gheimsch/Pulse_oximetry/Bericht/Titelbild.png

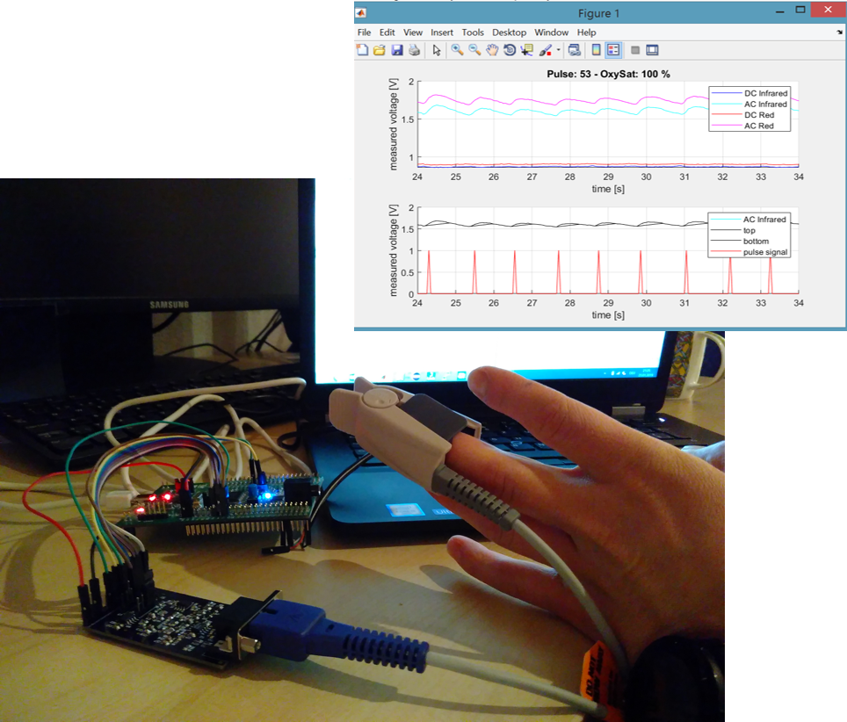
Bericht/Titelbild.png
