gheimsch/Pulse_oximetry/Bericht/IMG_20190123_212548.jpg

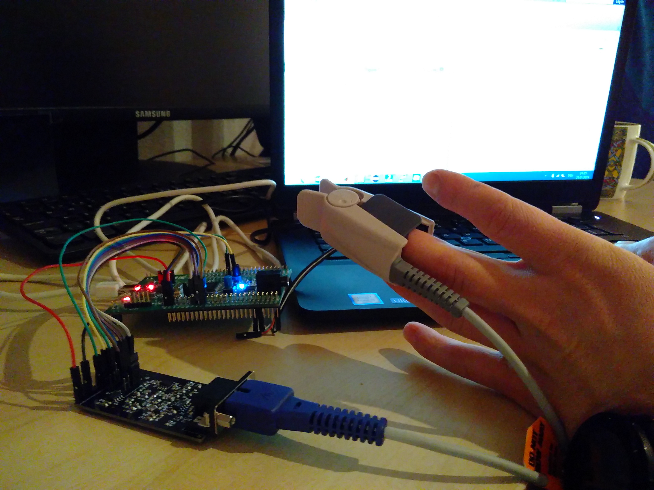
Bericht/IMG_20190123_212548.jpg
