gheimsch/Pulse_oximetry/README.md

# Pulse_oximetry
CAS Sensorik und Sensor Signal Conditioning Projektarbeit
