gheimsch/Pulse_oximetry/Bericht/Oxymeter.pptx

## Oximeter Messung von Puls und Sauerstoffsättigung

Gunnar Heimsch, Krista Kappeler
25.1.2019

## Agenda

- Ziele
- Messprinzip
- Medizinischer Hintergrund
- Dimensionierung und Simulation
- Schema
- Blockschaltbild
- Berechnung Puls und Sauerstoffsättigung
- Demo
- Vergleich zu anderen Produkten
- Fazit u. Schlusswort
- Fragen

## Ziel

- Elektronik bauen zum Aufnehmen und Aufbereiten (Signal Conditioning) von «Pulsoxymetrie» Rohdaten (Lichtsensor Infrarot und Rot)
- Visualisierung u. Auswertung der Rohdaten
- Vergleich mit anderen Produkten (z.B. eval board, fertiges Produkt, etc.)

## Messprinzip

- LED Rot – 665nm
- LED Infrarot – 940nm
- Fotodiode

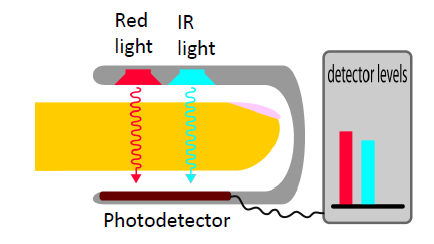
[picture p3: figure]

## Medizinischer Hintergrund

- Arterielles Blut pulsiert mit Herzfrequenz, enthält Hb02 u. Hb
- Sauerstoffsättigung: Verhältnis von HbO2 (Oxyhämoglobin) u. Hb (Hämoglobin)

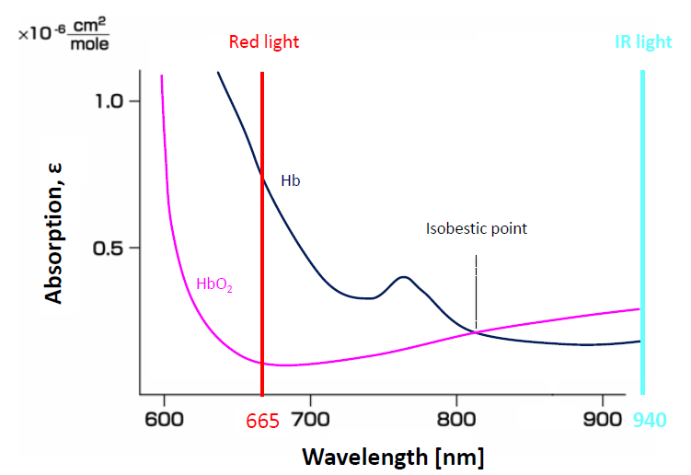
[picture p4: figure]
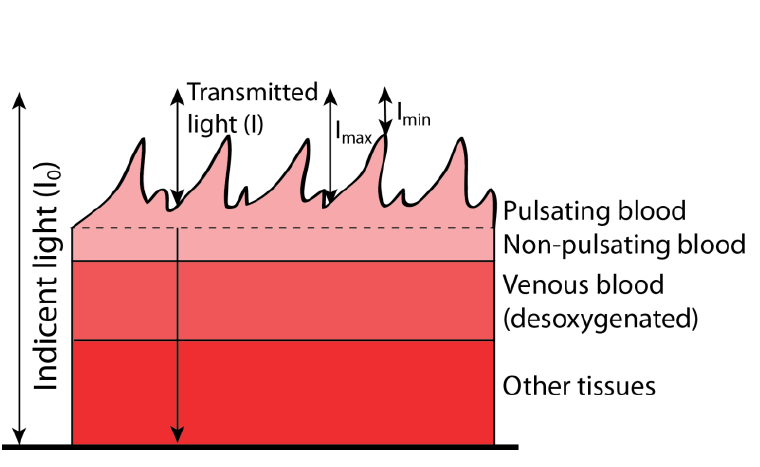
[picture p5: figure]

## Dimensionierung: Signal LED Infrarot

- Rohdaten mim Steckbrett
  - Basis für Auslegung
- Keine Infos über diesen IR Sensor

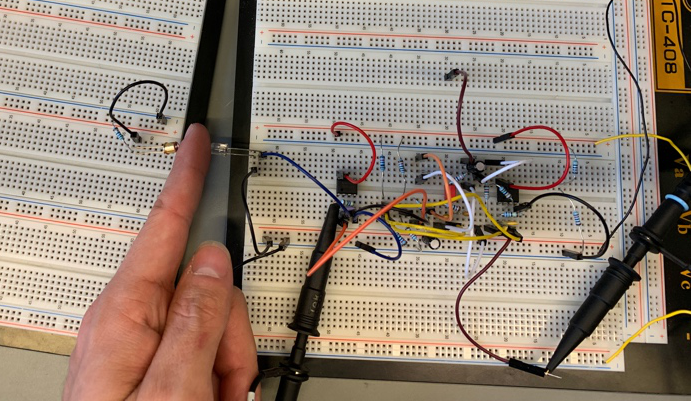
[picture p6: figure]
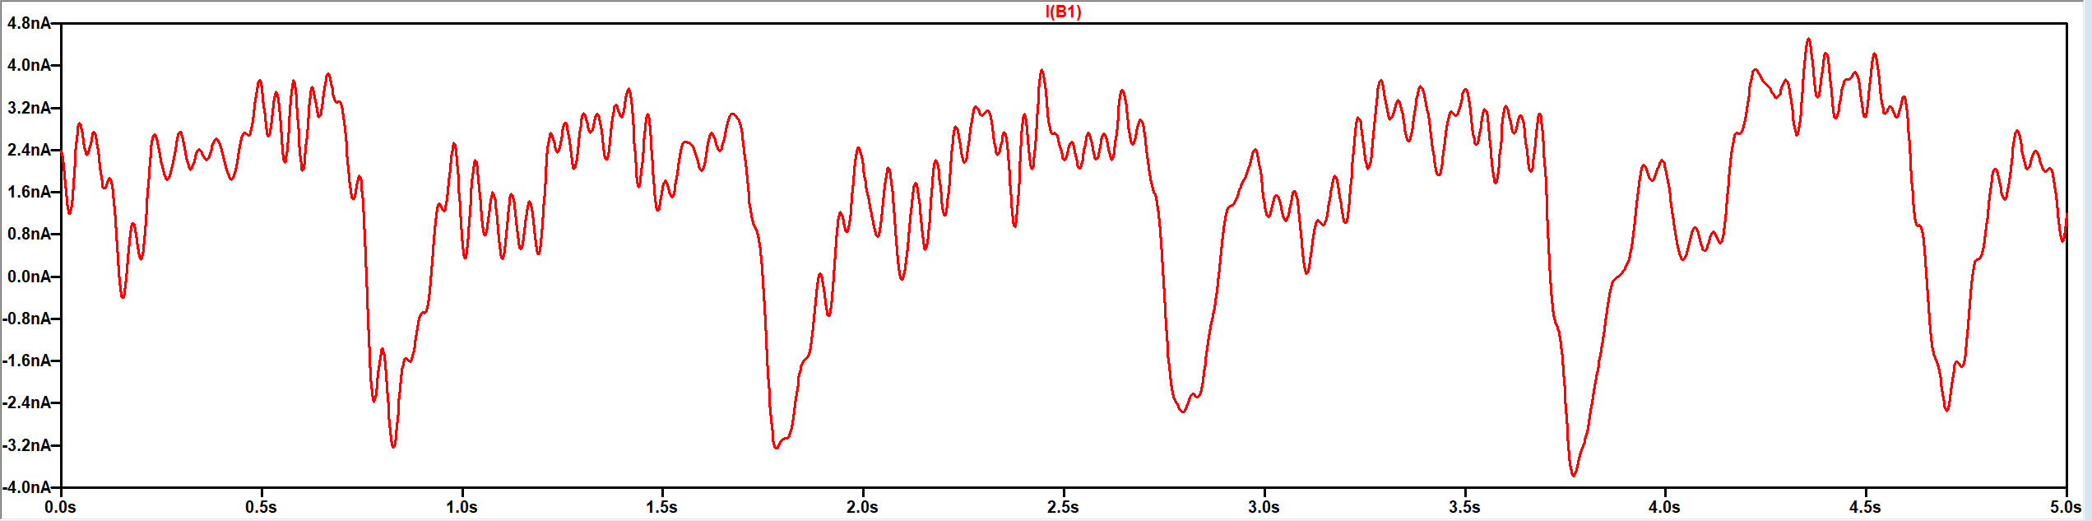
[picture p7: figure]

## Dimensionierung: Auslegung Filter

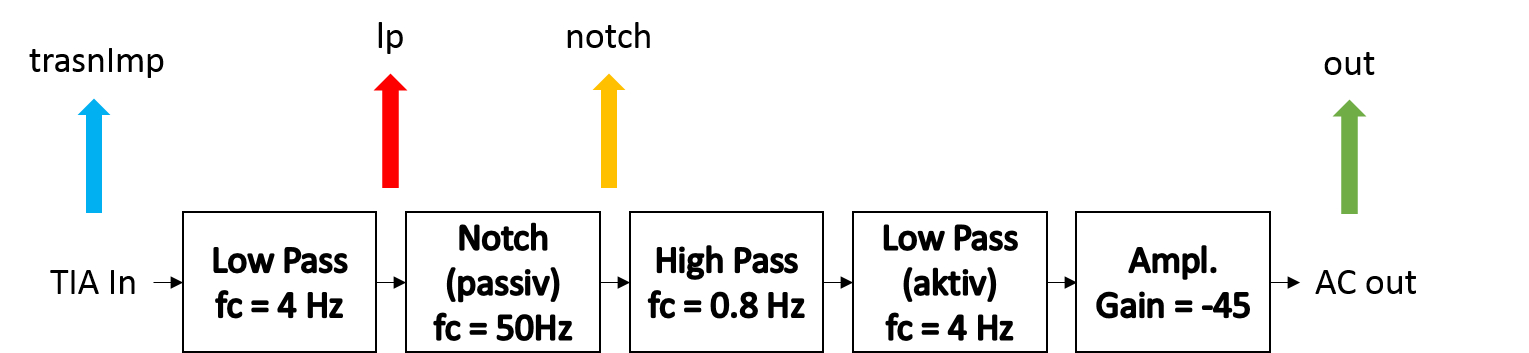
[picture p8: figure]
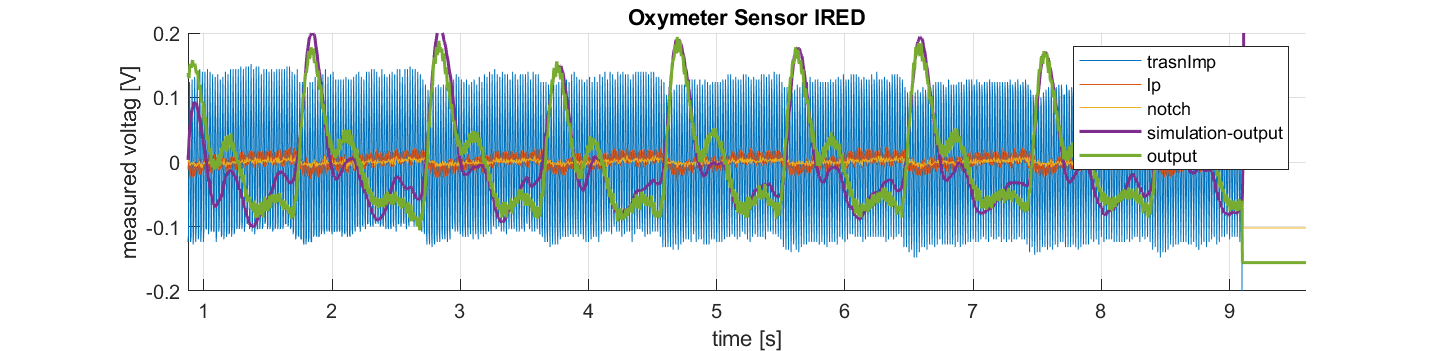
[picture p9: figure]

## Dimensionierung: Auslegung Notch Filter

- Aktiver Notch filter 50 Hz
  - Steiler ist nicht immer besser

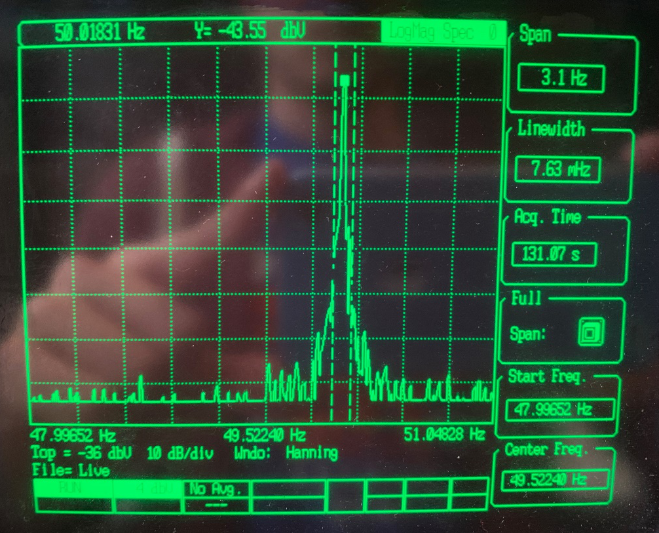
[picture p10: figure]
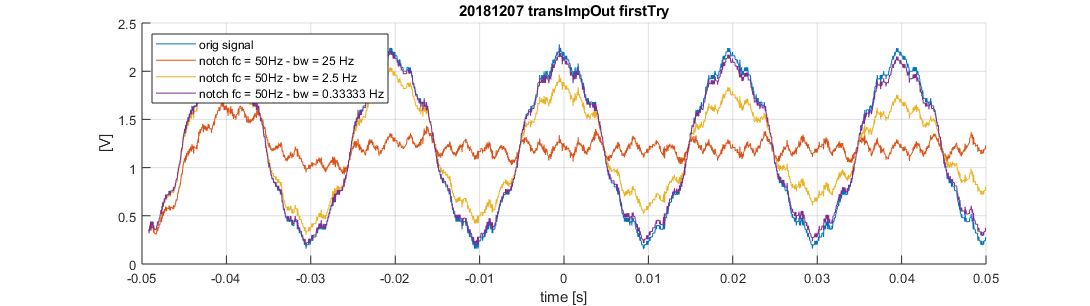
[picture p11: figure]

## Simulation: Gesamter Pfad

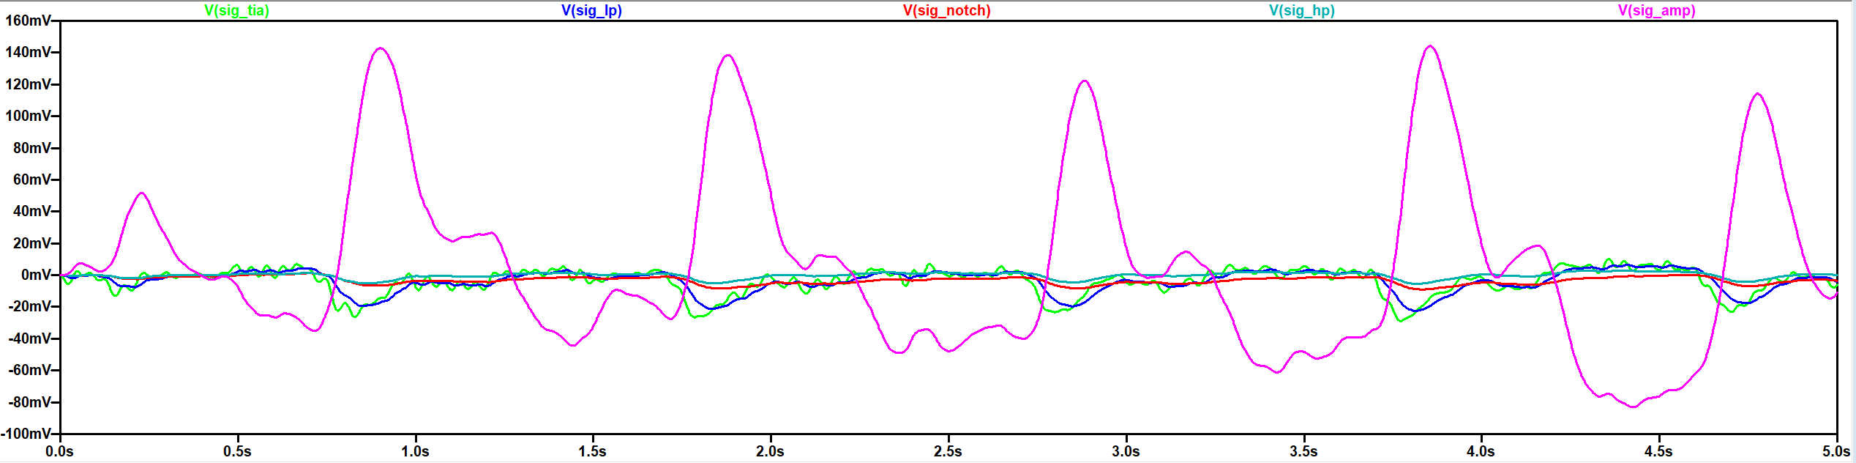
[picture p12: figure]
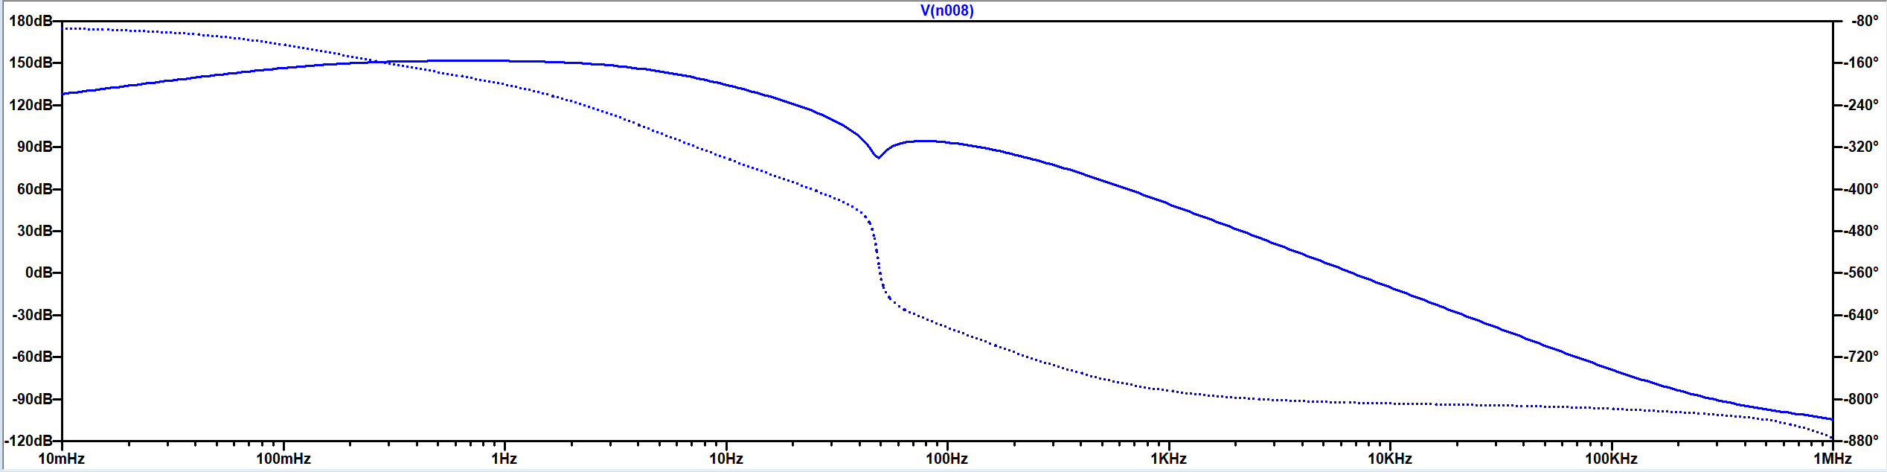
[picture p13: figure]

## Simulation: Stabilisierung TIA

- C_F = 1/(4∗π∗R_F ∗f_(GBWP))(1+√(1+8∗π∗C_i ∗f_(GBWP)))
- => ca. 0.5pF

## Simulation: Stabilisierung TIA

- Instabil ohne Feedback Kondensator

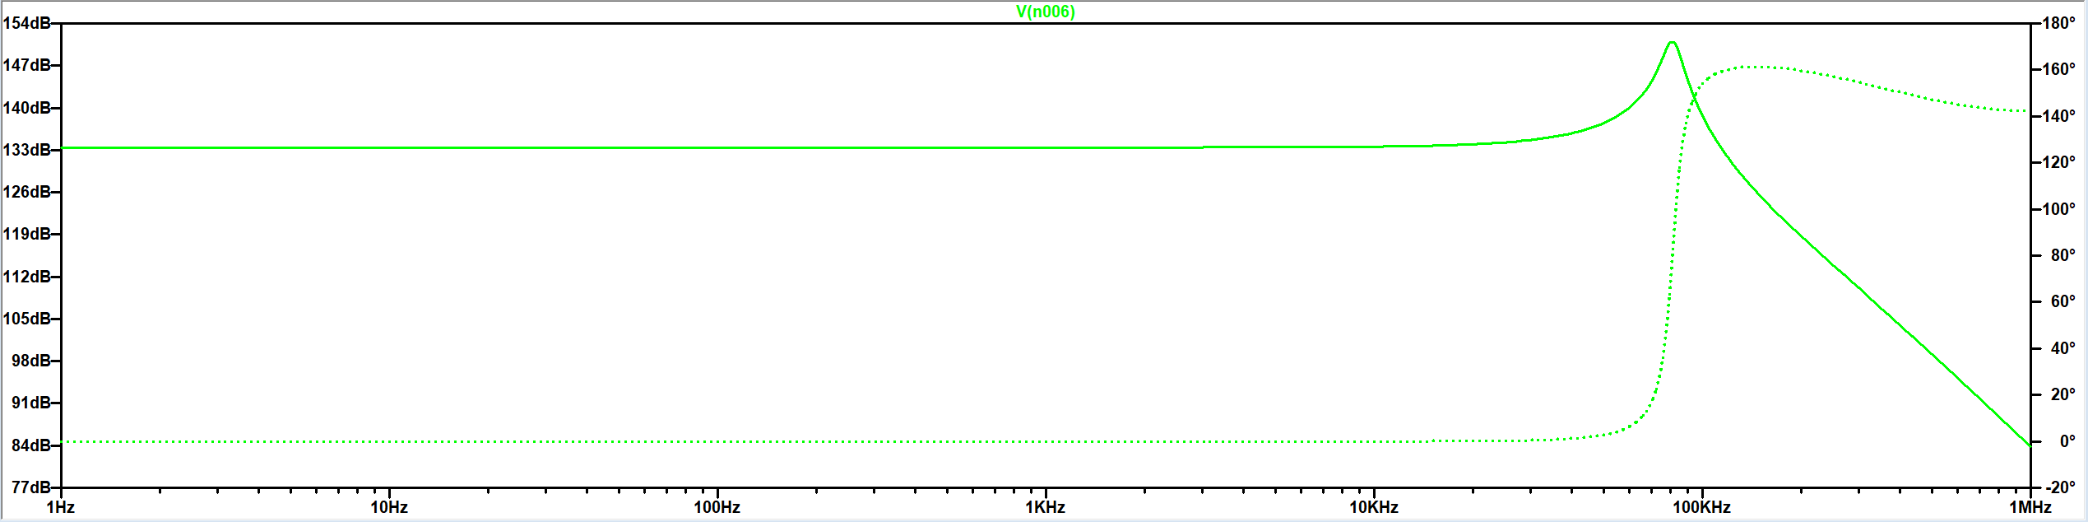
[picture p14: figure]

Stabil mit Feedback Kondensator 270pF

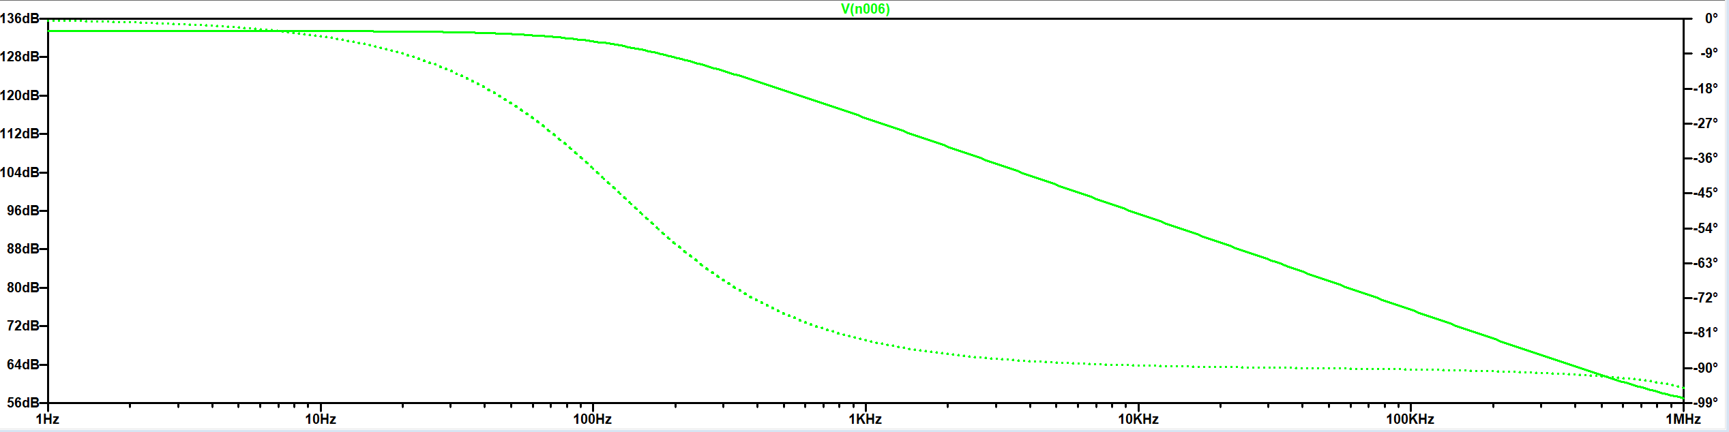
[picture p15: figure]

## Schema H-Brücke

- LED’s (Infrarot u. Rot) über eine H-Brücke angesteuert, da Sensor antiparallel geschaltet ist
- Mit DAC Strom der LED zwischen 0mA und 20mA einstellen
- R8 limitiert Strom → kein Kurzschluss

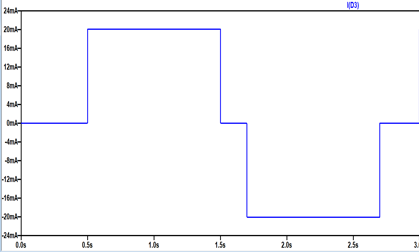
[picture p16: figure]
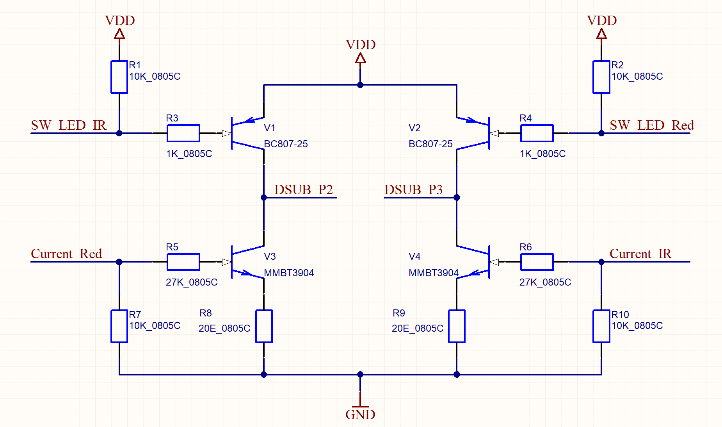
[picture p17: figure]

## Schema Filter, Verstärker

- TIA
- LP, Notch, HP, LP
- Verstärker G=-45

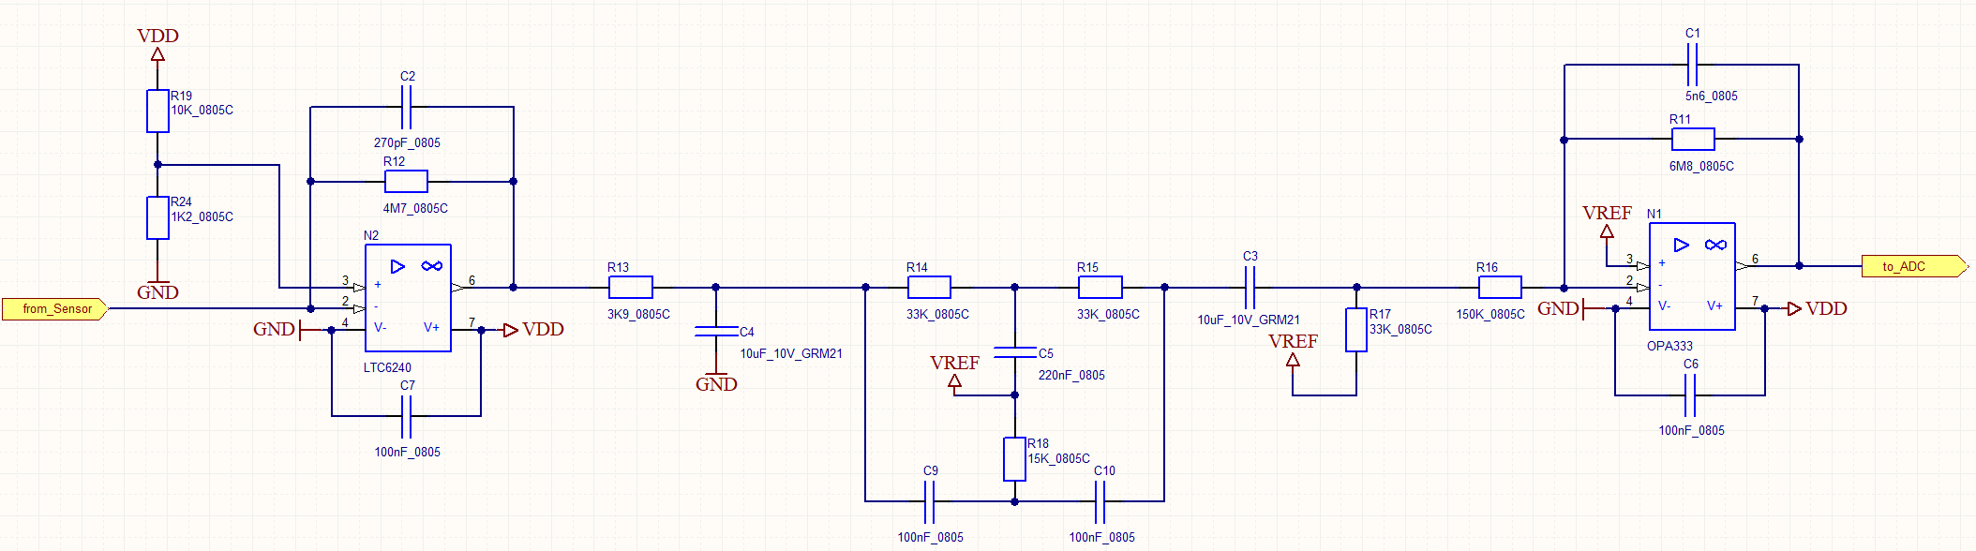
[picture p18: figure]

## Blockschaltbild

- STM32F4-Discovery für analoge Werte, Steuerung H-Brücke
- Rohdaten mittels UART an PC vermittelt
- Auswertung mit Matlab

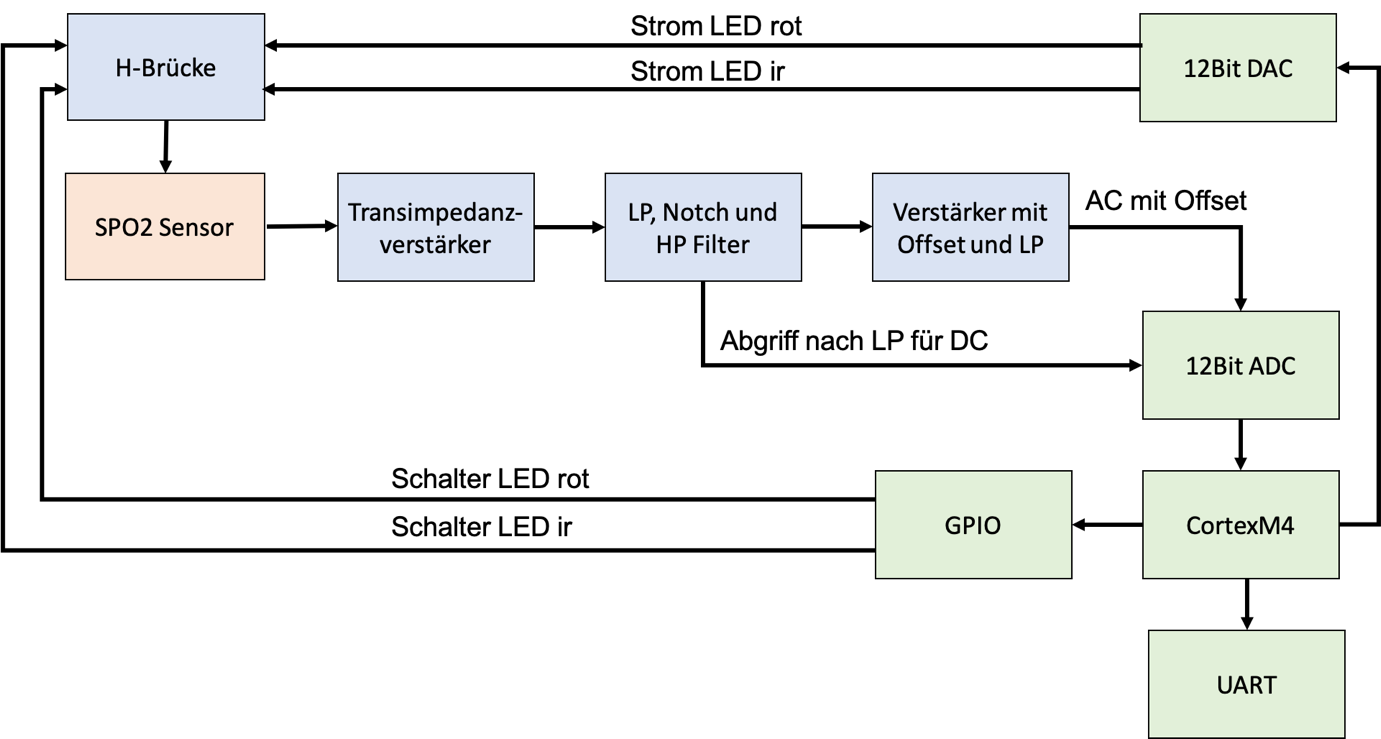
[picture p19: figure]

## Berechnungen: Puls und Sauerstoffsättigung

- Sauerstoffsättigung
Oxy_(Sat) [%] − 100∗(log_10 (V_(RMS) R))/(log_(10(V_(RMS) IR)))
- Puls
  - Peak Detektion
  - Frequenz 1 Hz bis 3 Hz (d.h. 60 bis 180 Schläge pro Min)

## Demo Projekt

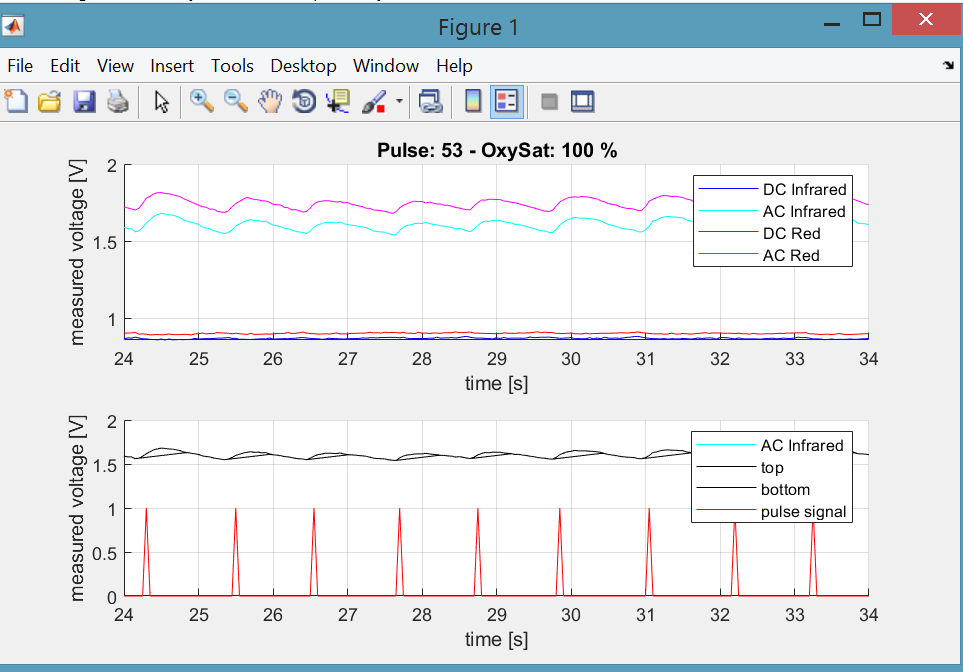
[picture p20: figure]
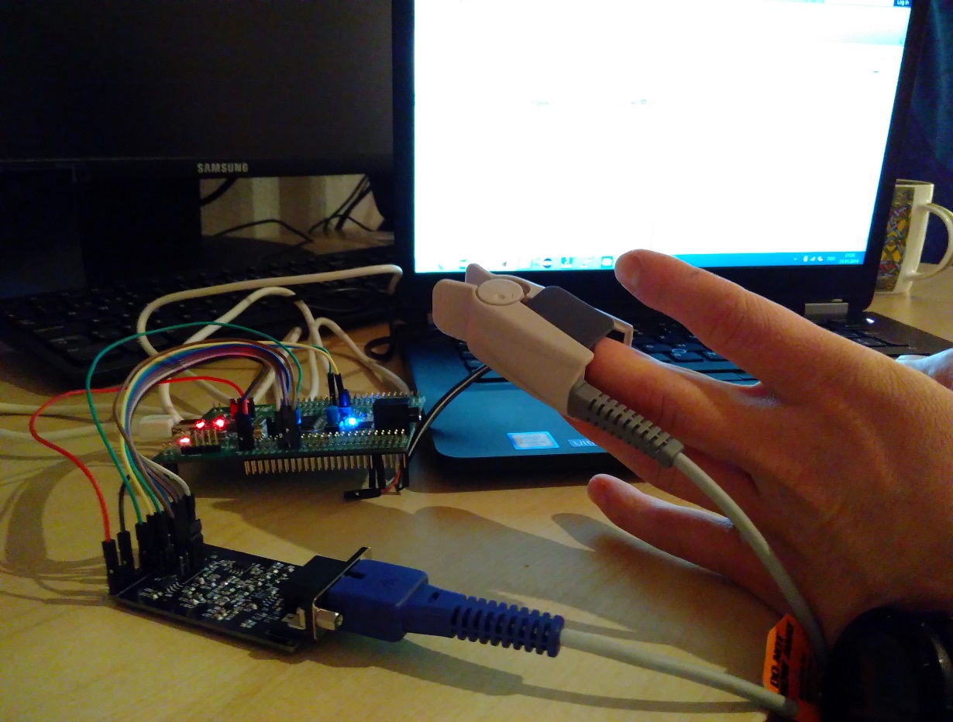
[picture p21: figure]
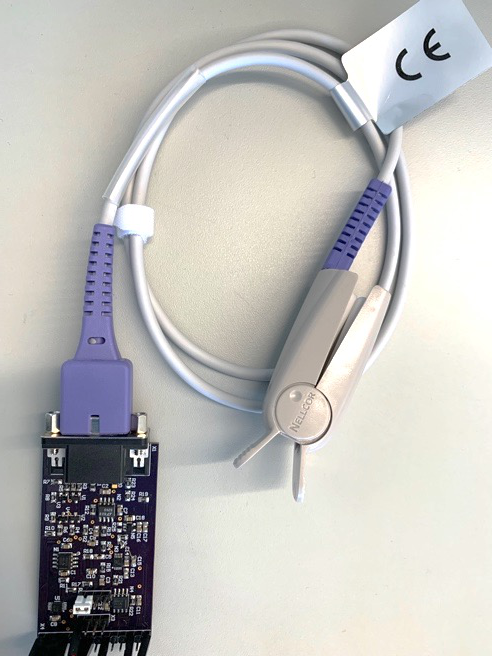
[picture p22: figure]

## Vergleich zu anderen Produkten

- Produkte zum Erfassen von Pulse und SPO2 Werte (Bspl.)
  - MAX30105 von Maxim Integrated
  - AFE4490 von TI
- Demonstrator mit: MAX30105, der LED’s, Fotodiode und AFE
- Diese Produkte liefern Rohdaten => Auswertung ist dem Benutzer überlassen

## Fazit und Schlusswort

- Signalaufbereitung
  - schnell eine funktionierende Lösung
  - Vorgehen mit Steckbrett und Beispielsensor hat sich bewährt
- Berechnungen zur Sauerstoffsättigung waren zeitaufwändig
  - Berechnung aus Applications Notes und Papers nicht vollständig nachvollziehbar («Berufsgeheimnis»)
  - Fehlende Referenzmessungen zu tiefe Sauerstoffsättigung
- Offene Punkte
  - zwei Fehler auf PCB
  - Ansatz verfolgen (1): statt LED Strom zu verändern, Gain und Offset von Verstärker verändern
  - Ansatz verfolgen (2): Daten beim TIA abzugreifen, Filterung digital

## Fragen
