gheimsch/Pulse_oximetry/Bericht/filterDesign.pptx

Low Pass
fc = 4 Hz

Notch (passiv)
fc = 50Hz

High Pass
fc = 0.8 Hz

Low Pass (aktiv)
fc = 4 Hz

Ampl.
Gain = -45

TIA In

AC out

trasnImp

lp

notch

out
