gheimsch/Pulse_oximetry/Papers/5. Pulse Oximetry/Solution 5.1.pdf

# Solutions 5.1

1) For an adult with a SpO2

at 100%, an estimated blood supplies of 5l/min. What is the amount of O2

supplied to the tissues in ml O2

/min.

100ml blood -> 20.7ml O2
5l blood -> 1035ml O2
5l blood /min -> 1035ml O2
| /min
2) Knowing that the tissues need an average of 250 ml O2

/min, what is the percentage of O2 used? What is the vein oxygen saturation? And the corresponding partial pressure?

24.1% (=250/1035) is used
vein oxygen saturation, SvO2= 75.9% (100%-24.1%)
From the O2 dissociation curve, we read a partial pressure of 40mmHg

278

# Solutions 5.1

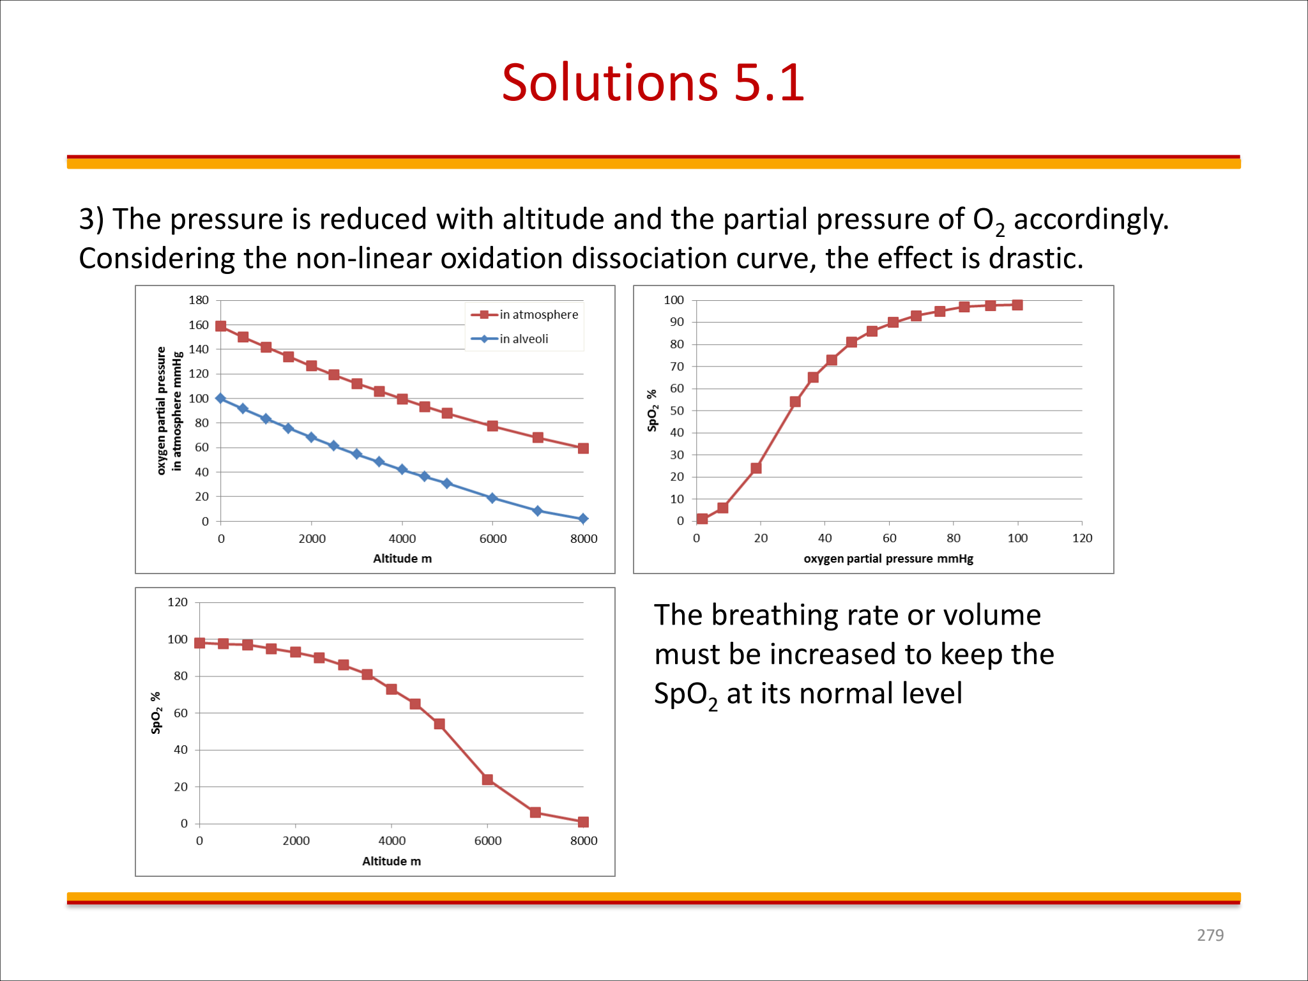
[picture p31: page 2]

3) The pressure is reduced with altitude and the partial pressure of O2

accordingly.
Considering the non-linear oxidation dissociation curve, the effect is drastic.

279

The breathing rate or volume must be increased to keep the SpO2

at its normal level
