gheimsch/Pulse_oximetry/Bericht/2019_01_23_21_28_23_MATLAB_R2018a.png

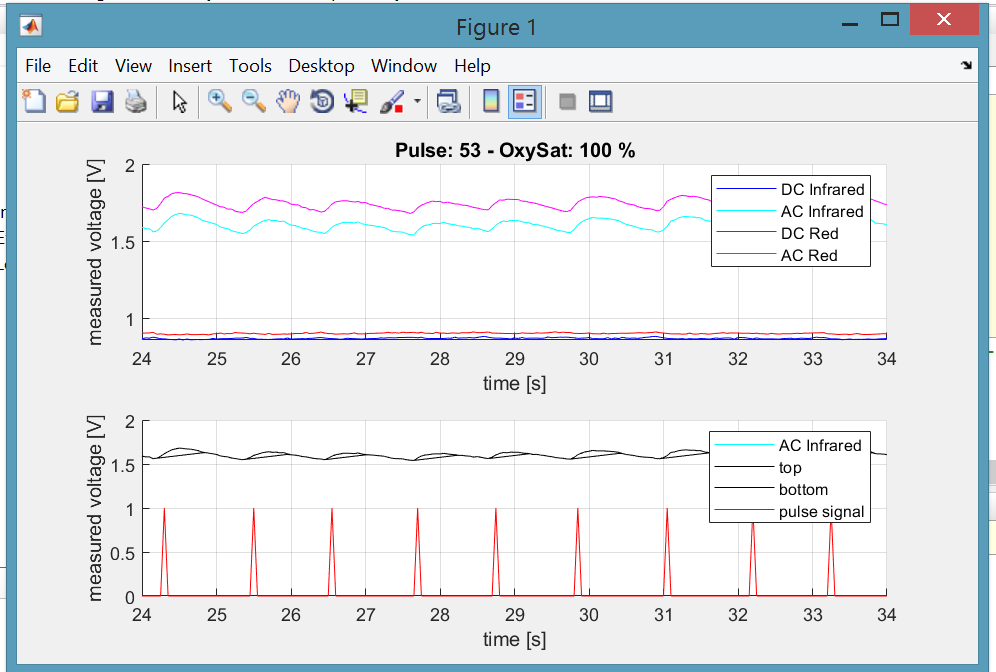
Bericht/2019_01_23_21_28_23_MATLAB_R2018a.png
