gheimsch/Pulse_oximetry/Bericht/Bilder/AMP_Sim.PNG

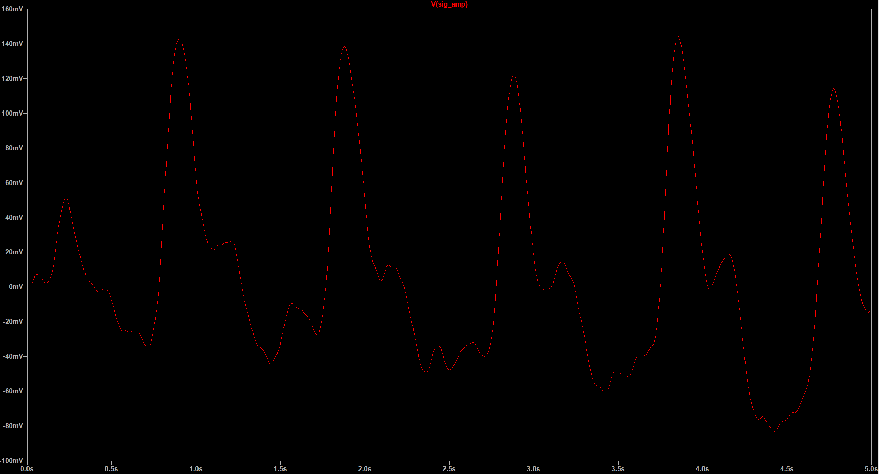
Bericht/Bilder/AMP_Sim.PNG
