gheimsch/Pulse_oximetry/Bericht/Bilder/Amplifier_Schema.PNG

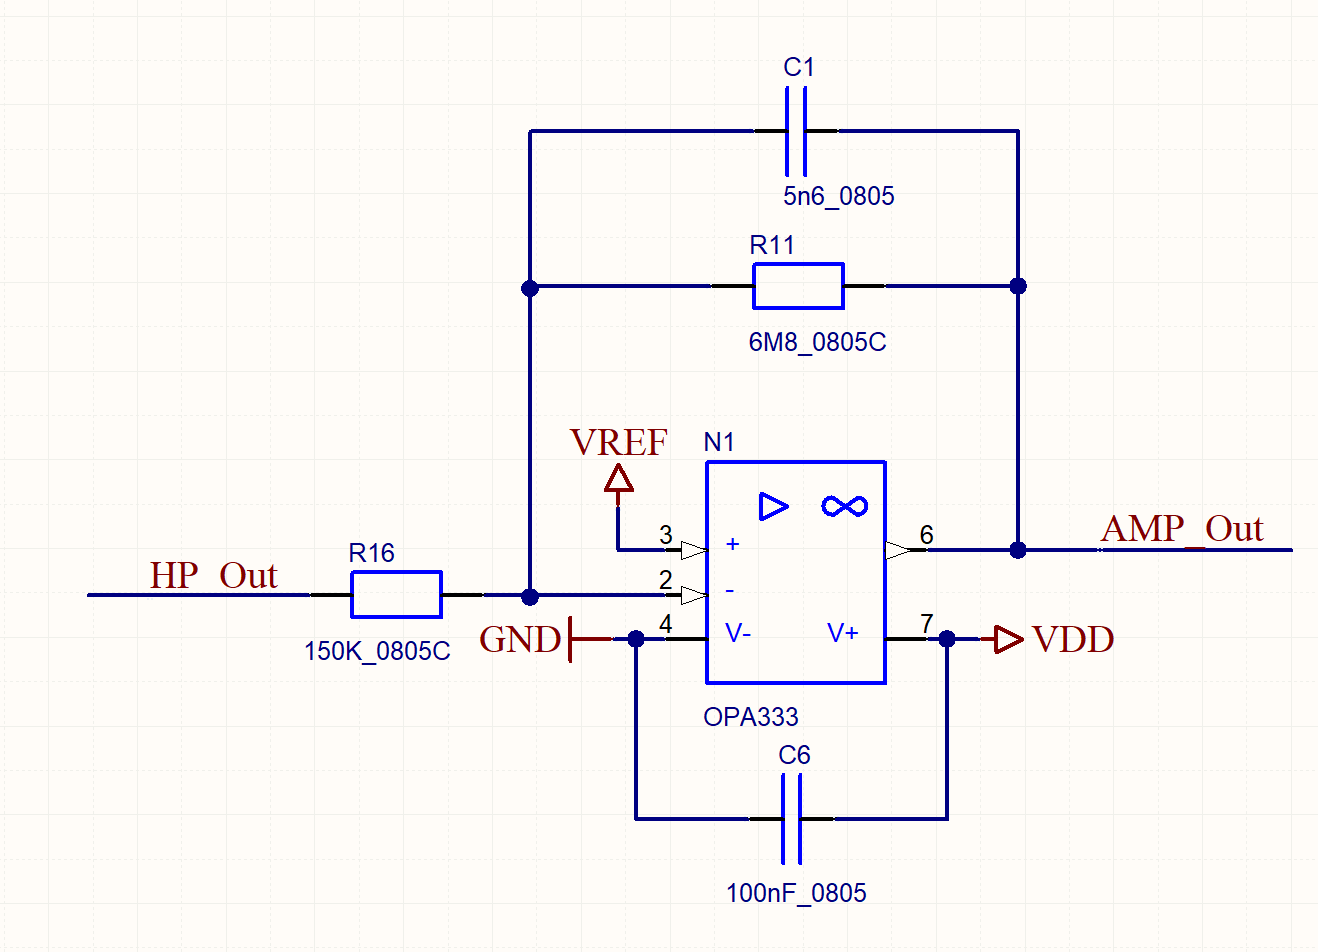
Bericht/Bilder/Amplifier_Schema.PNG
