gheimsch/Pulse_oximetry/Bericht/Bilder/H-Brücke.PNG

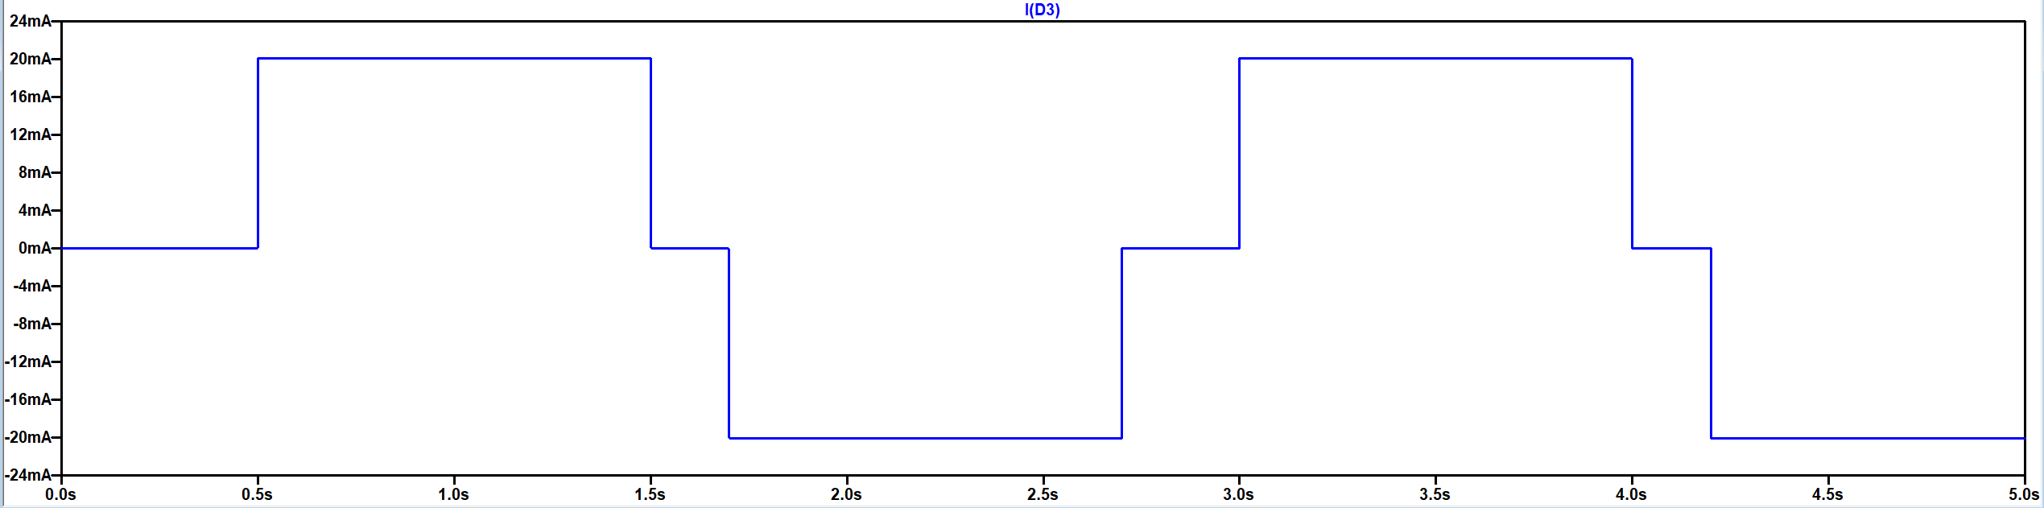
Bericht/Bilder/H-Brücke.PNG
