gheimsch/Pulse_oximetry/Bericht/Bilder/H_Brücke_Sim_LED.PNG

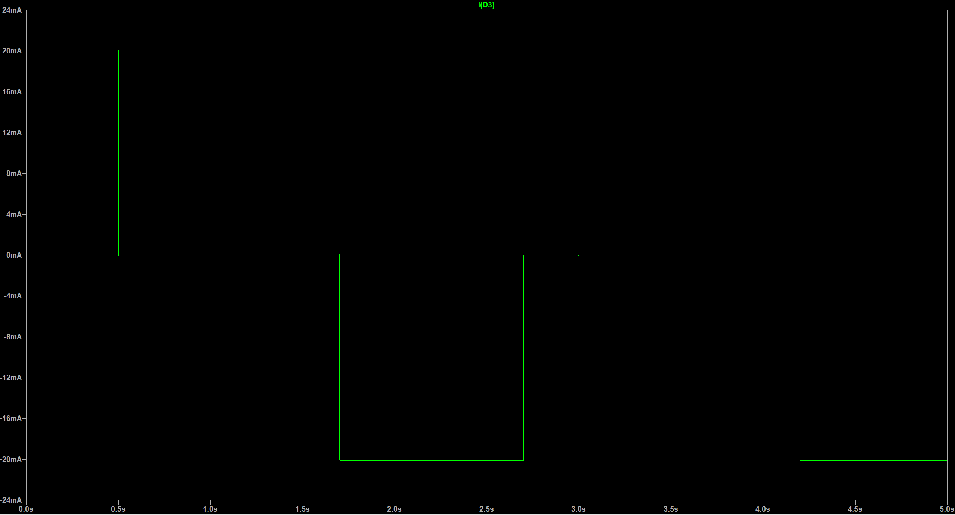
Bericht/Bilder/H_Brücke_Sim_LED.PNG
