gheimsch/Pulse_oximetry/Bericht/Bilder/HP_Schema.PNG

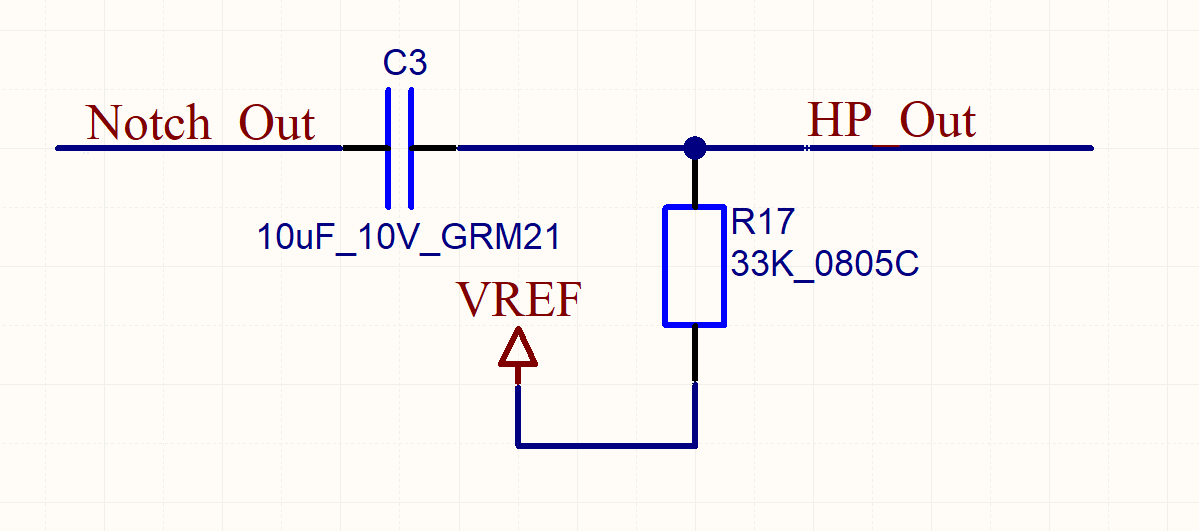
Bericht/Bilder/HP_Schema.PNG
