gheimsch/Pulse_oximetry/Bericht/Bilder/HP_Sim.PNG

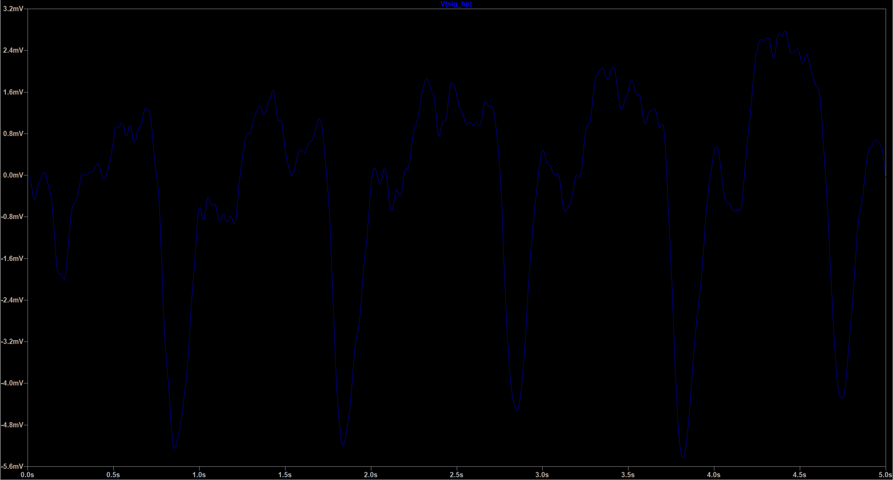
Bericht/Bilder/HP_Sim.PNG
