gheimsch/Pulse_oximetry/Bericht/Bilder/LP_Notch_Sim.PNG

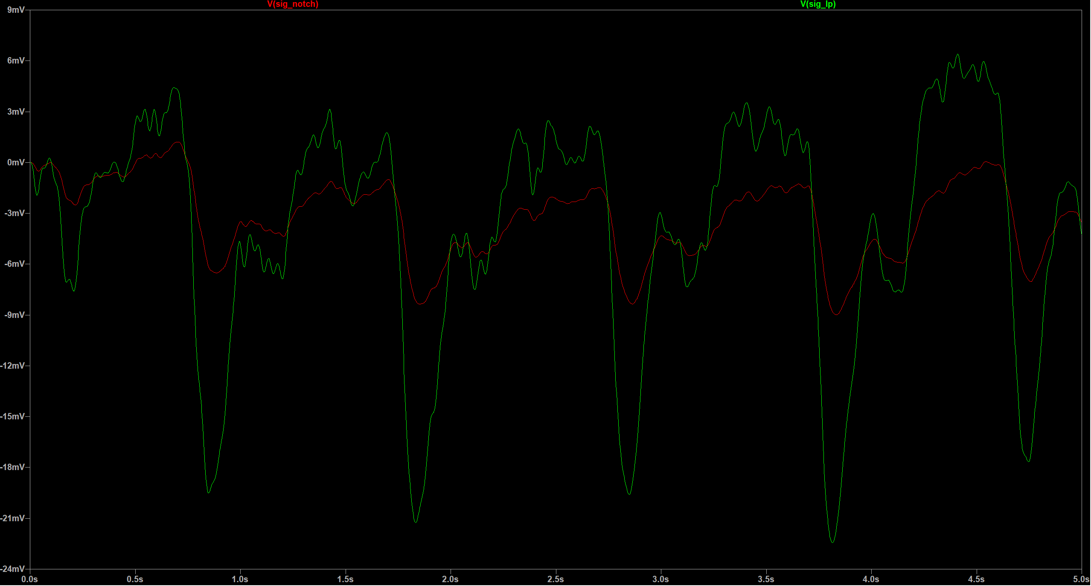
Bericht/Bilder/LP_Notch_Sim.PNG
