gheimsch/Pulse_oximetry/Bericht/Bilder/LP_Schema.PNG

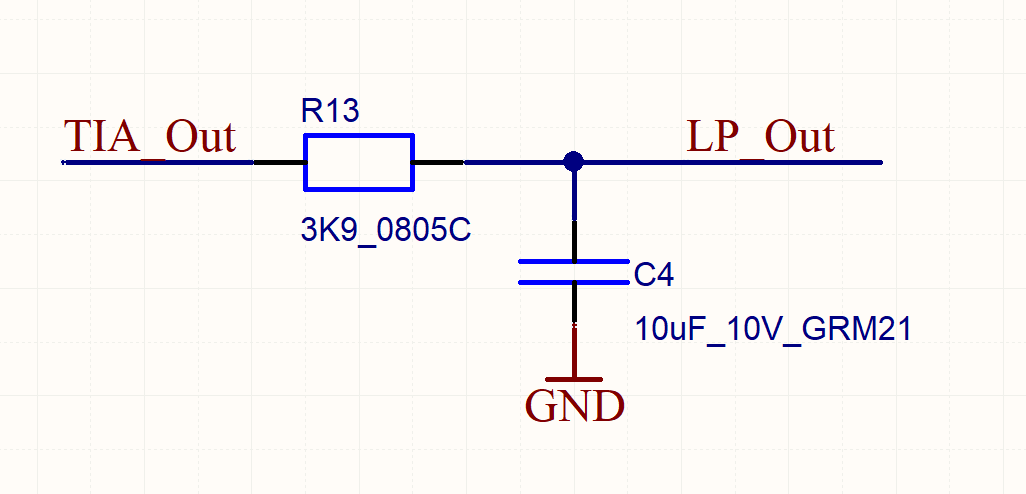
Bericht/Bilder/LP_Schema.PNG
