gheimsch/Pulse_oximetry/Bericht/Bilder/Notch_HP_Sim.PNG

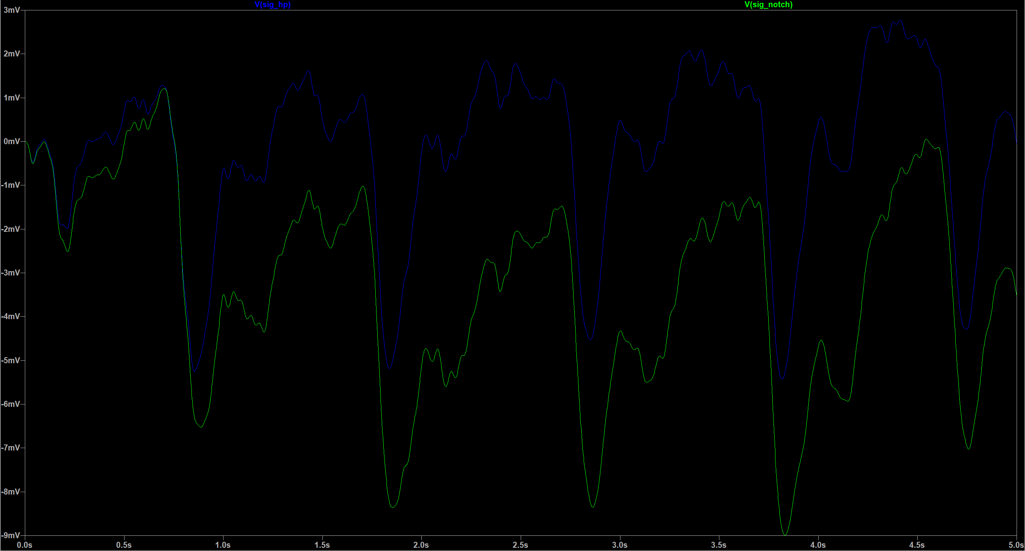
Bericht/Bilder/Notch_HP_Sim.PNG
