gheimsch/Pulse_oximetry/Bericht/Bilder/Notch_Out_Sim.PNG

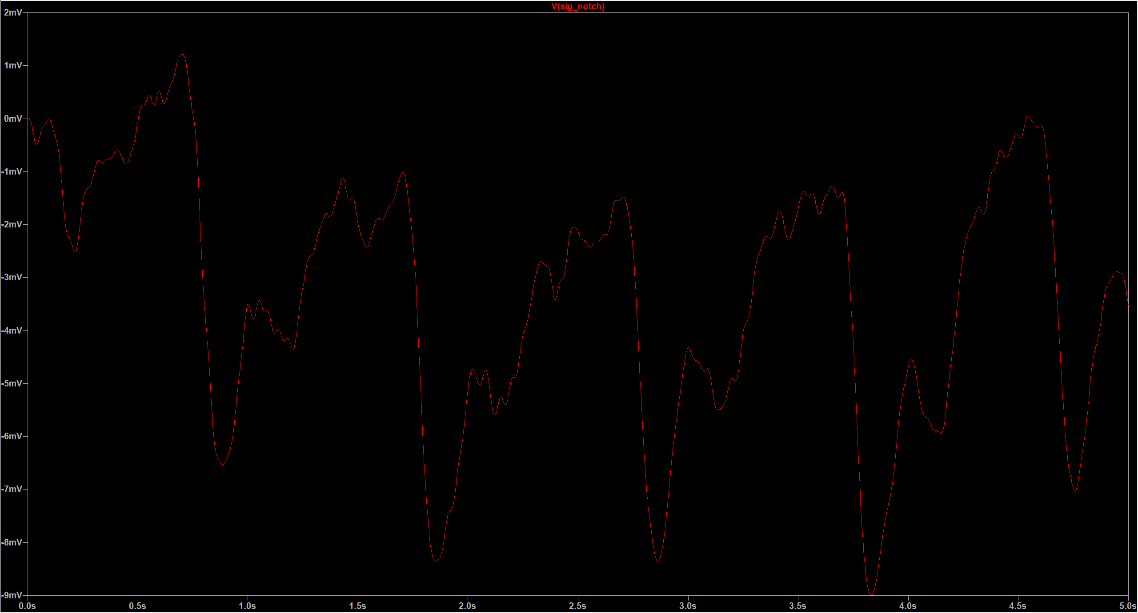
Bericht/Bilder/Notch_Out_Sim.PNG
