gheimsch/Pulse_oximetry/Bericht/Bilder/Notch_Schema.PNG

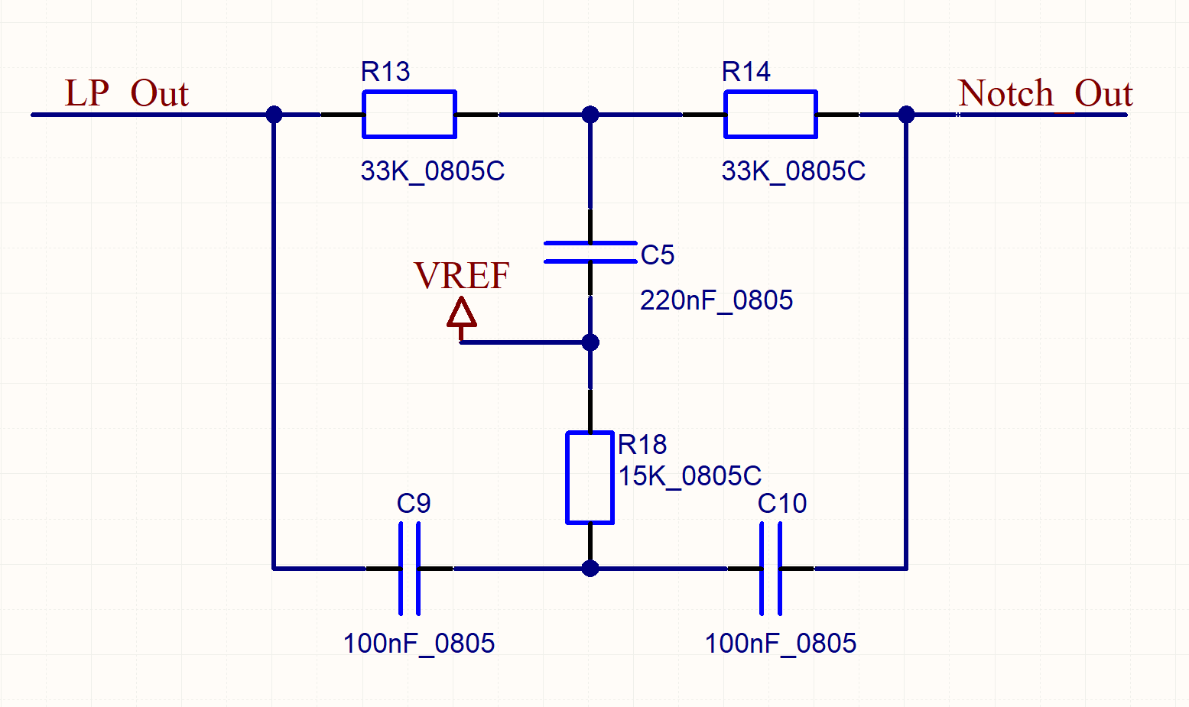
Bericht/Bilder/Notch_Schema.PNG
