gheimsch/Pulse_oximetry/Bericht/Bilder/Sensor_Out_Sim.PNG

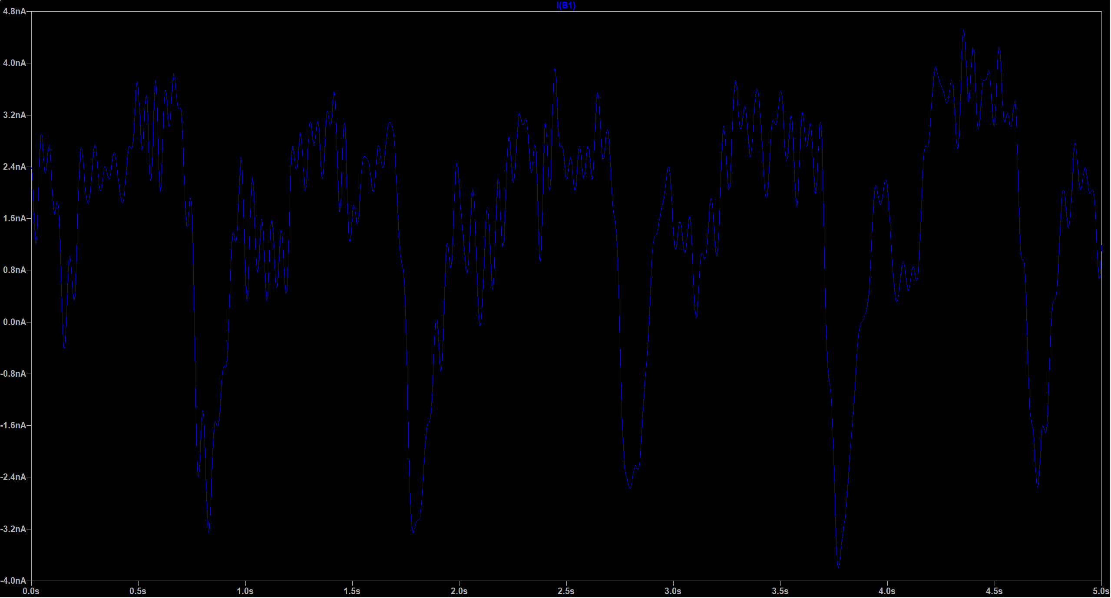
Bericht/Bilder/Sensor_Out_Sim.PNG
