gheimsch/Pulse_oximetry/Bericht/Bilder/Sim_All.PNG

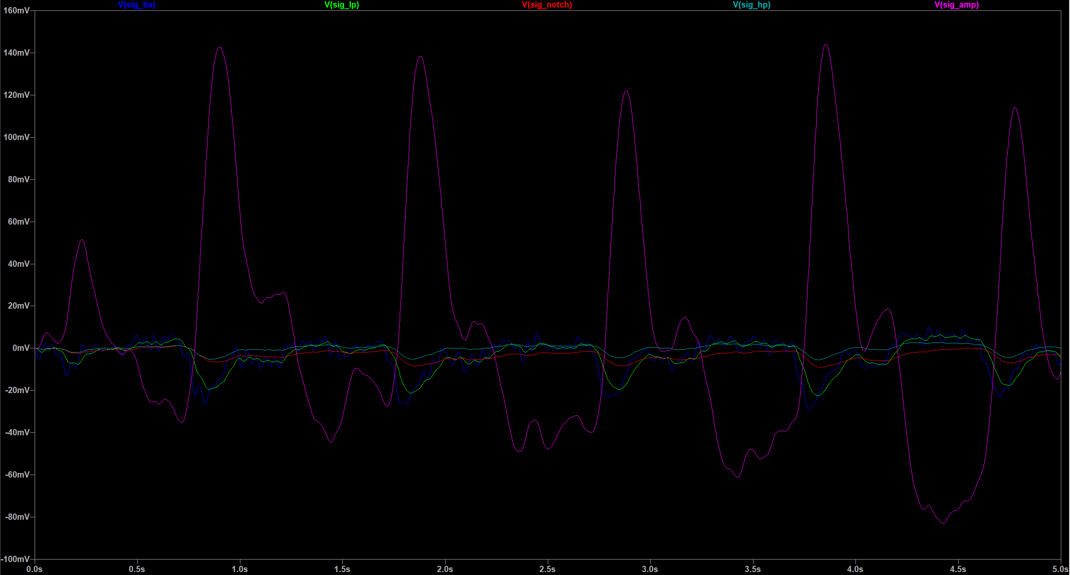
Bericht/Bilder/Sim_All.PNG
