gheimsch/Pulse_oximetry/Bericht/Bilder/TIA_LP_Sim.PNG

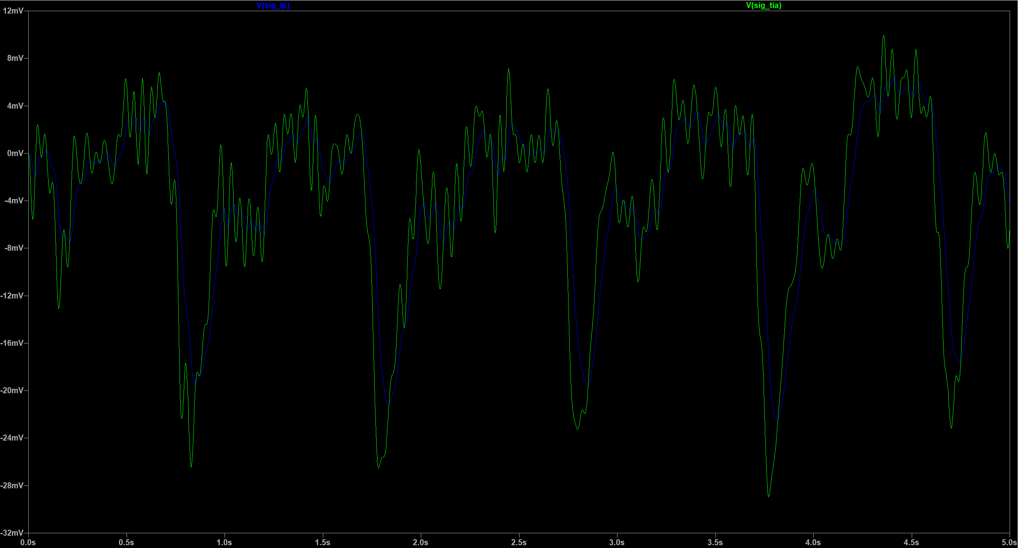
Bericht/Bilder/TIA_LP_Sim.PNG
