gheimsch/Pulse_oximetry/Bericht/Bilder/TIA_Schema.PNG

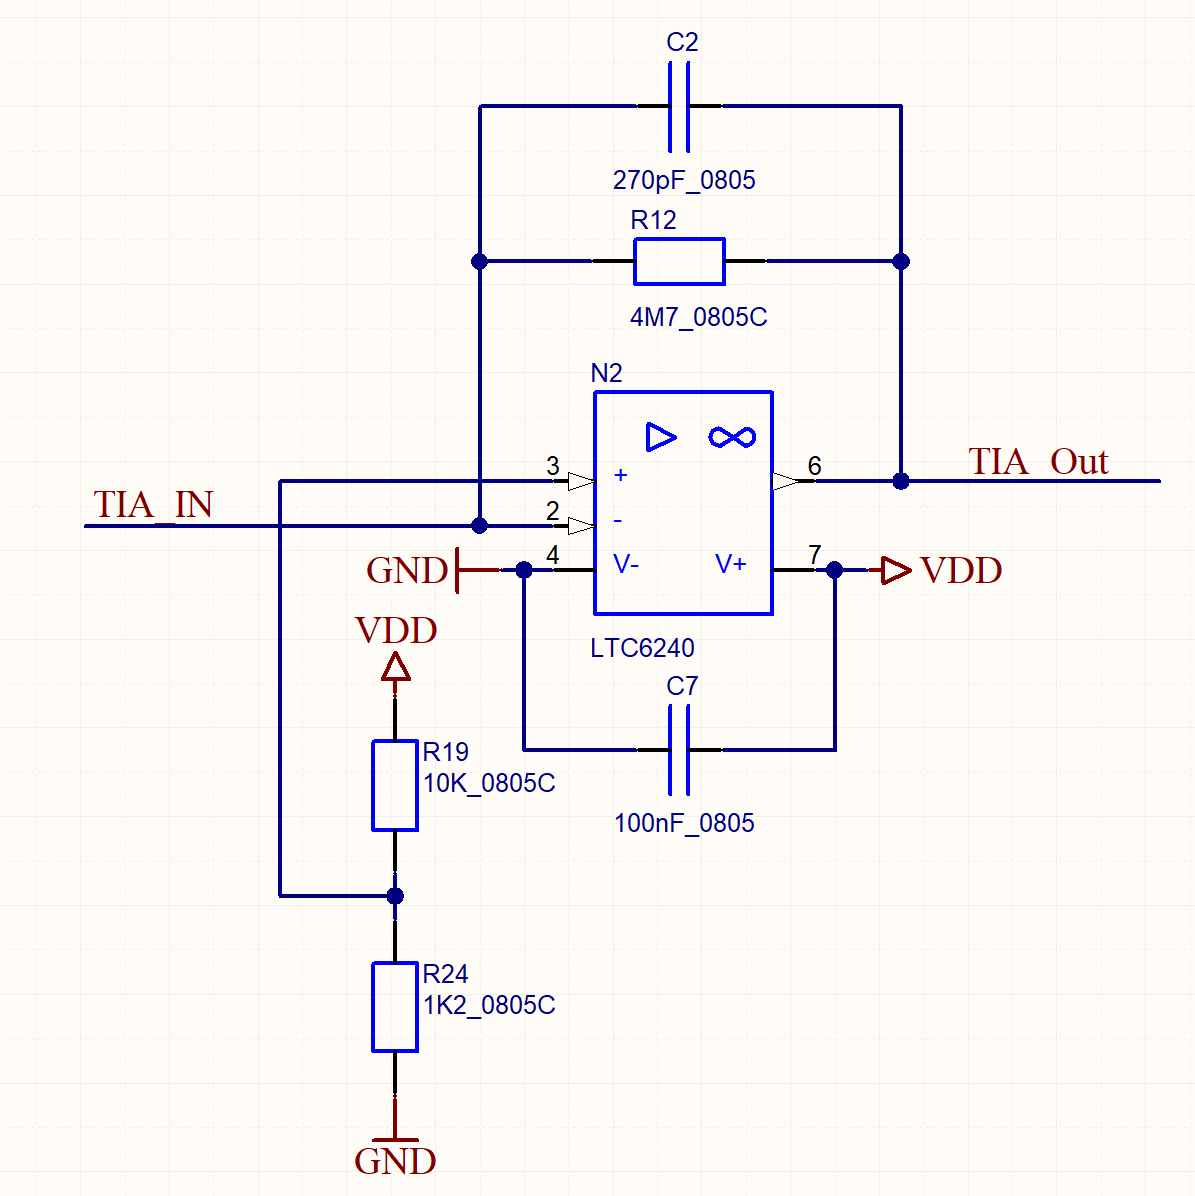
Bericht/Bilder/TIA_Schema.PNG
