gheimsch/Pulse_oximetry/Matlab/origNotch.png

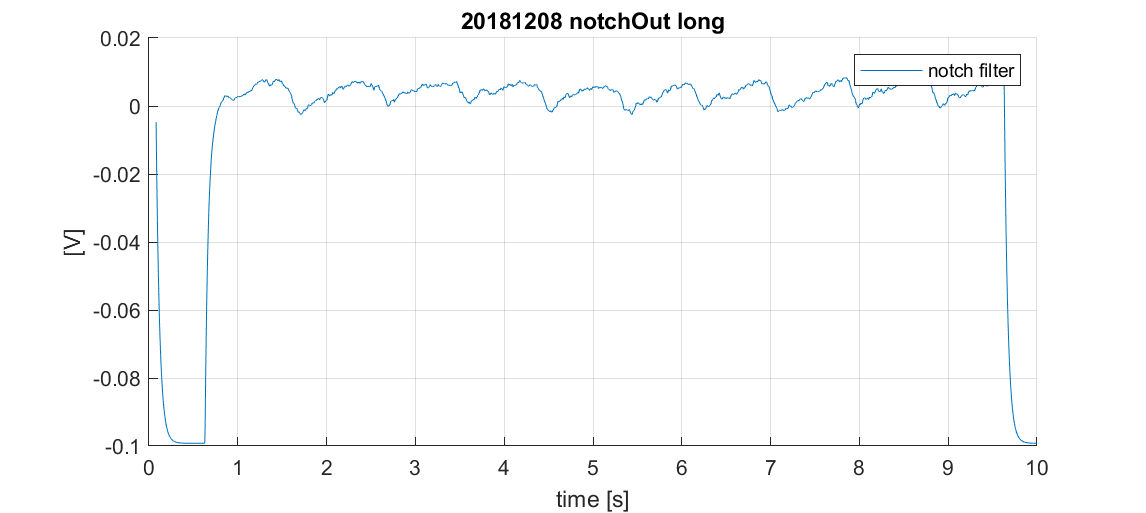
Matlab/origNotch.png
