gheimsch/Pulse_oximetry/Matlab/origNotch_long.png

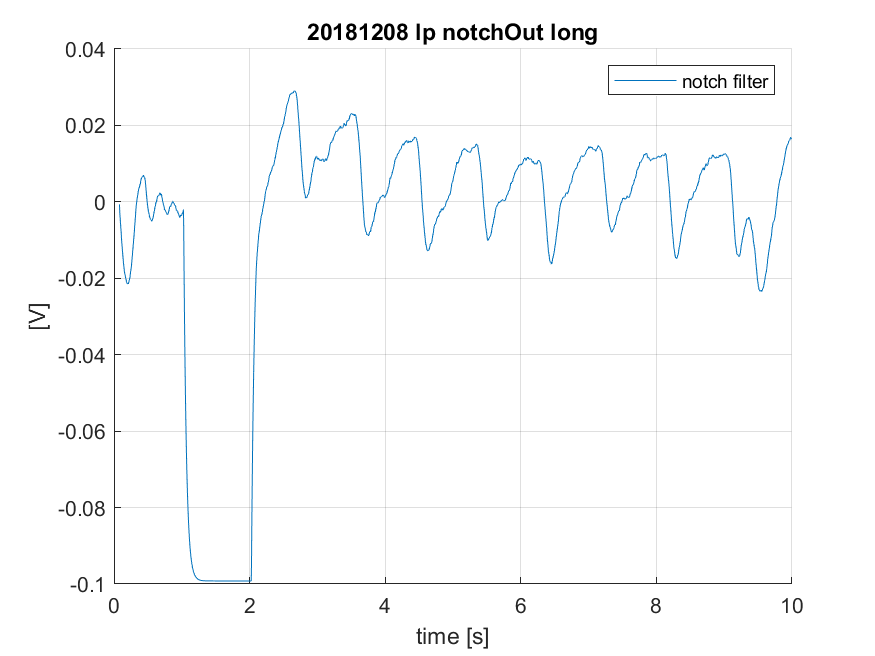
Matlab/origNotch_long.png
