gheimsch/Pulse_oximetry/Matlab/origTransImpOut.png

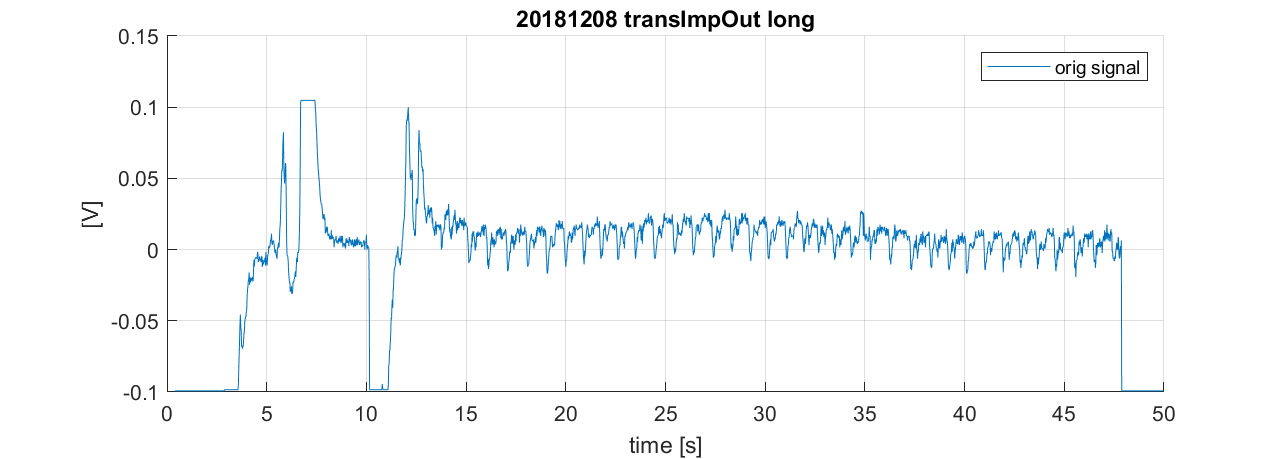
Matlab/origTransImpOut.png
