gheimsch/Pulse_oximetry/Matlab/out.png

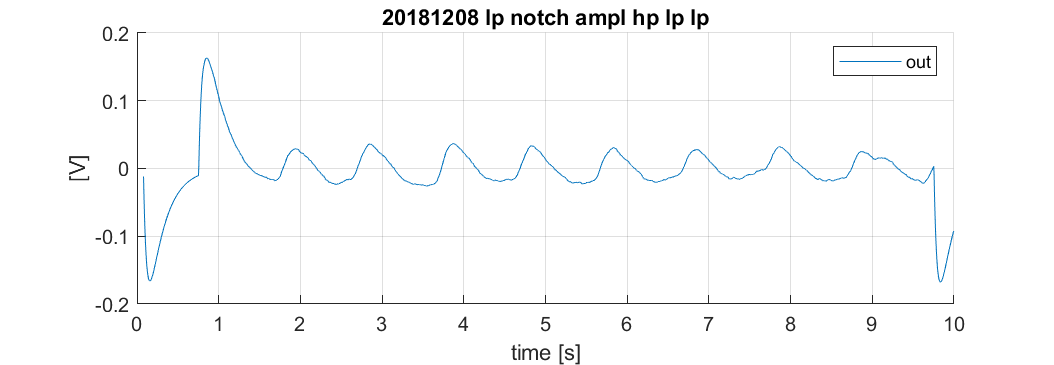
Matlab/out.png
