gheimsch/Pulse_oximetry/Pictures/IMG_5708.png

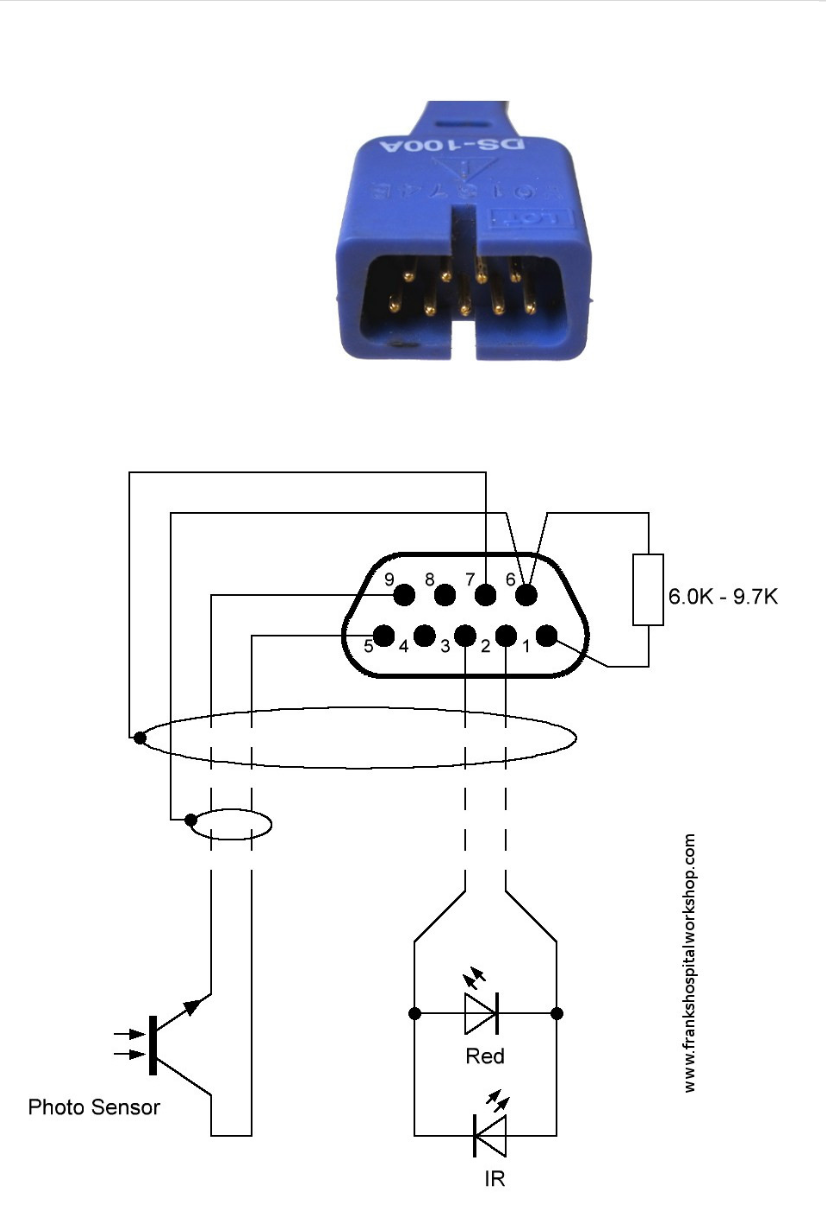
Pictures/IMG_5708.png
