gheimsch/Pulse_oximetry/Pictures/IMG_5709.png

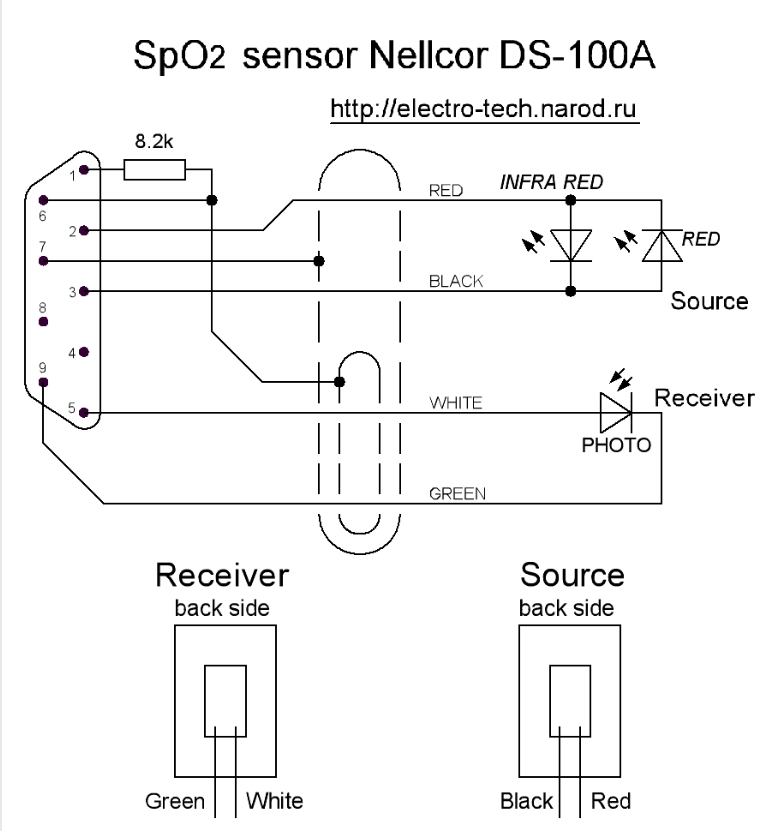
Pictures/IMG_5709.png
