gheimsch/Pulse_oximetry/PCB/Output job/Oximeter.xlsx

Comment | Description | Designator | Footprint | Manufacturer Part Nr | Quantity
5n4_0805 | Kond.Keramik SMD Typ X7R 2,2nF B37941-K5222-K60 0805 | C1, C11 | 0805MIL |  | 2
270pF_0805 | Kond.Keramik Siemens Typ COG SMD 0805 | C2 | 0805MIL |  | 1
10uF_10V_GRM21 | Monolithic Ceramic Capacitor 10uF/10V GRM21BR61A106KE19L | C3, C4, C14, C16 | 0805MIL | GRM21BR61A106KE19L | 4
220nF_0805 | Kond.Keramik Siemens Typ X7R SMD 0805 | C5 | 0805MIL |  | 1
100nF_0805 | Kond.Keramik Typ X7R SMD 0805 100nF | C6, C7, C8, C9, C10, C12, C15, C17, C18 | 0805MIL |  | 9
1uF_0805_100V | Kond.Keramik TDK Typ X7S SMD 0805 1uF/100V | C13 | 0805MIL | C2012X7S2A105K125AB | 1
39E | SMD Ferrit MPZ2012S331A 330Ohm | L1 | 0805MIL | MPZ2012S331A | 1
OPA333 | SMD Low Power Precision Op.Amp. OPA211AIDR SOIC8 | N1, N2, N4 | SOP8_150_65 | OPA211AIDR | 3
AD5272 | Digitalpotentiometer 1024tap 100k | N3 | MSOP10 |  | 1
TLV2371IDBVR | 3MHz Rail-to-Rail OpAmp TLV2371IDBVR SOT23-5 | N5 | SOT23-5 | TLV2371IDBVR | 1
10K_0805C | Widerst.Chip SMD 1% 0.1W 0805 Serie HMWA 10 kOhm | R1, R2, R7, R10, R19, R25, R26 | 0805MIL |  | 7
1K_0805C | Widerst.Chip SMD 1% 0.1W 0805 Serie HMWA 1 kOhm | R3, R4 | 0805MIL |  | 2
27K_0805C | Widerst.Chip SMD 1% 0.1W 0805 Serie HMWA 27 kOhm | R5, R6 | 0805MIL |  | 2
20E_0805C | Widerst.Chip SMD 0.1% 0.1W 0805 Serie RN73 20 Ohm | R8, R9 | 0805MIL |  | 2
6M8_0805C | Widerst.Chip SMD 1% 0.1W 0805 Serie HMWA 1 MOhm | R11, R22 | 0805MIL |  | 2
4M7_0805C | Widerst.Chip SMD 1% 0.1W 0805 Serie HMWA 1 MOhm | R12 | 0805MIL |  | 1
3K9_0805C | Widerst.Chip SMD 1% 0.1W 0805 Serie HMWA 3,9 kOhm | R13 | 0805MIL |  | 1
33K_0805C | Widerst.Chip SMD 1% 0.1W 0805 Serie HMWA 33 kOhm | R14, R15, R17 | 0805MIL |  | 3
150K_0805C | Widerst.Chip SMD 1% 0.1W 0805 Serie HMWA 150 kOhm | R16 | 0805MIL |  | 1
15K_0805C | Widerst.Chip SMD 1% 0.1W 0805 Serie HMWA 15 kOhm | R18 | 0805MIL |  | 1
0E0_0805C | Widerst.Chip SMD 1% 0.1W 0805 Serie HMWA 0Ohm | R20, R23 | 0805MIL |  | 2
56K_0805C | Widerst.Chip SMD 1% 0.1W 0805 Serie HMWA 56 kOhm | R21 | 0805MIL |  | 1
1K2_0805C | Widerst.Chip SMD 1% 0.1W 0805 Serie HMWA 1,2 kOhm | R24 | 0805MIL |  | 1
ADS1115IDGST | 16-Bit ADC with Integrated Multiplexer, PGA, Comparator, Oscillator, and Reference, -40 to 125 degC, 10-pin SOP (DGS10), Green (RoHS & no Sb/Br) | U1 | TI-DGS10_N |  | 1
BC807-25 | PNP-Transistor SMD BC807-25 SOT-23 | V1, V2 | SOT23 | BC807-25 | 2
MMBT3904 | Transistor NPN MMBT3904 SOT-23 | V3, V4 | SOT23 |  | 2
D-SUB9_S_ABG | D-SUB 9 Sok 90° mit Winkel und Abstandsbolzen DT09SYC1M63UNB6 | X1 | DSUB_9_F_ABG | DT09SYC1M63UNB6 | 1
SL1-053-04G | 2.54mm Stiftleiste 1reihig 4pol gerade SL1 053 04G | X2, X3 | SL105304 | SL1-053-04G | 2
X-14P | Stiftenleiste 14 pin | X4 | SIP14 |  | 1
