gheimsch/Pulse_oximetry/Measurements/rawData/20181207_transImpOut_firstTry.CSV

Record Length | 2.500000e+03 | -0.050000000000 | 0.24000
Sample Interval | 4.000000e-05 | -0.049960000000 | 0.24000
Trigger Point | 1.250000000000e+03 | -0.049920000000 | 0.24000
 |  | -0.049880000000 | 0.28000
 |  | -0.049840000000 | 0.28000
 |  | -0.049800000000 | 0.24000
Source | CH1 | -0.049760000000 | 0.28000
Vertical Units | V | -0.049720000000 | 0.28000
Vertical Scale | 1.000000e+00 | -0.049680000000 | 0.28000
Vertical Offset | 0.000000e+00 | -0.049640000000 | 0.28000
Horizontal Units | s | -0.049600000000 | 0.28000
Horizontal Scale | 1.000000e-02 | -0.049560000000 | 0.32000
Pt Fmt | Y | -0.049520000000 | 0.28000
Yzero | 0.000000e+00 | -0.049480000000 | 0.28000
Probe Atten | 1.000000e+01 | -0.049440000000 | 0.28000
Model Number | TBS1064 | -0.049400000000 | 0.32000
Serial Number | C011211 | -0.049360000000 | 0.32000
Firmware Version | FV:v26.05 | -0.049320000000 | 0.32000
 |  | -00.049280000000 | 0.36000
 |  | -00.049240000000 | 0.32000
 |  | -00.049200000000 | 0.36000
 |  | -00.049160000000 | 0.32000
 |  | -00.049120000000 | 0.36000
 |  | -00.049080000000 | 0.40000
 |  | -00.049040000000 | 0.36000
 |  | -00.049000000000 | 0.44000
 |  | -00.048960000000 | 0.44000
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
