gheimsch/Pulse_oximetry/Measurements/rawData/20181208_lp_notchOut_long.CSV

Record Length | 2.500000e+03 | 0.000000000000 | 0.01520
Sample Interval | 4.000000e-03 | 0.004000000000 | 0.01120
Trigger Point | 0.000000000000e+00 | 0.008000000000 | 0.01040
 |  | 0.012000000000 | 0.00960
 |  | 0.016000000000 | 0.00880
 |  | 0.020000000000 | 0.01040
Source | CH1 | 0.024000000000 | 0.00960
Vertical Units | V | 0.028000000000 | 0.01040
Vertical Scale | 2.000000e-02 | 0.032000000000 | 0.00560
Vertical Offset | -3.200000e-03 | 0.036000000000 | 0.00240
Horizontal Units | s | 0.040000000000 | 0.00720
Horizontal Scale | 1.000000e+00 | 0.044000000000 | 0.00560
Pt Fmt | Y | 0.048000000000 | 0.00720
Yzero | 0.000000e+00 | 0.052000000000 | 0.00080
Probe Atten | 1.000000e+01 | 0.056000000000 | -0.00160
Model Number | TBS1064 | 0.060000000000 | -0.00160
Serial Number | C011211 | 0.064000000000 | -0.00720
Firmware Version | FV:v26.05 | 0.068000000000 | -0.00960
 |  | 0.072000000000 | -0.00640
 |  | 0.076000000000 | -0.01120
 |  | 0.080000000000 | -0.01360
 |  | 0.084000000000 | -0.01920
 |  | 0.088000000000 | -0.01440
 |  | 0.092000000000 | -0.01440
 |  | 0.096000000000 | -0.01600
 |  | 0.100000000000 | -0.01600
 |  | 0.104000000000 | -0.01760
 |  | 0.108000000000 | -0.02160
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
