gheimsch/Pulse_oximetry/Measurements/rawData/20181208_lp_notch_ampl46_hp_lp.CSV

Record Length | 2.500000e+03 | 0.000000000000 | -0.10400
Sample Interval | 4.000000e-03 | 0.004000000000 | -0.10800
Trigger Point | 0.000000000000e+00 | 0.008000000000 | -0.10800
 |  | 0.012000000000 | -0.10400
 |  | 0.016000000000 | -0.10000
 |  | 0.020000000000 | -0.10000
Source | CH1 | 0.024000000000 | -0.10000
Vertical Units | V | 0.028000000000 | -0.09600
Vertical Scale | 1.000000e-01 | 0.032000000000 | -0.08800
Vertical Offset | -1.600000e-02 | 0.036000000000 | -0.09200
Horizontal Units | s | 0.040000000000 | -0.08400
Horizontal Scale | 1.000000e+00 | 0.044000000000 | -0.09600
Pt Fmt | Y | 0.048000000000 | -0.09200
Yzero | 0.000000e+00 | 0.052000000000 | -0.08800
Probe Atten | 1.000000e+01 | 0.056000000000 | -0.08400
Model Number | TBS1064 | 0.060000000000 | -0.08400
Serial Number | C011211 | 0.064000000000 | -0.08400
Firmware Version | FV:v26.05 | 0.068000000000 | -0.08000
 |  | 0.072000000000 | -0.08000
 |  | 0.076000000000 | -0.08000
 |  | 0.080000000000 | -0.07600
 |  | 0.084000000000 | -0.08000
 |  | 0.088000000000 | -0.08000
 |  | 0.092000000000 | -0.06800
 |  | 0.096000000000 | -0.07600
 |  | 0.100000000000 | -0.06800
 |  | 0.104000000000 | -0.06800
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
