gheimsch/Pulse_oximetry/Matlab/measuredSignal_oxySensor.png

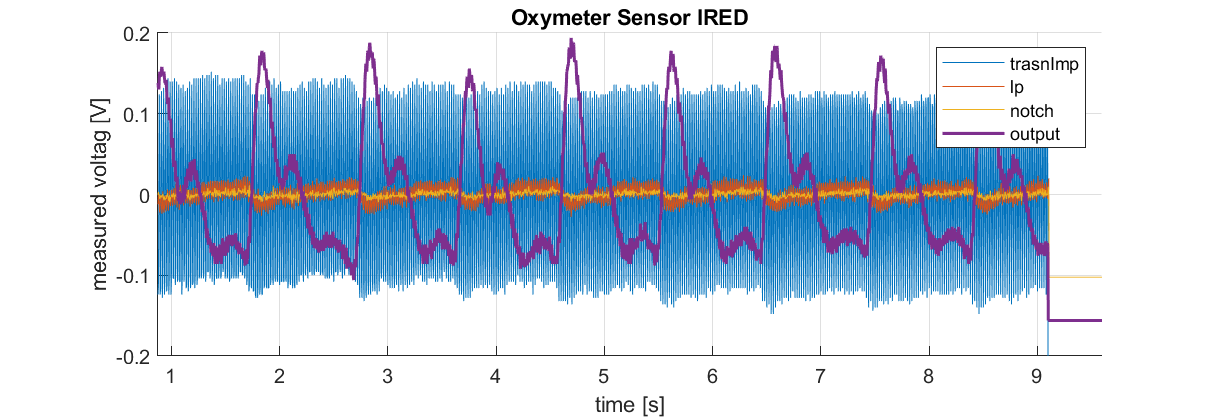
Matlab/measuredSignal_oxySensor.png
