gheimsch/Pulse_oximetry/PCB/Output job/Oximeter.pdf

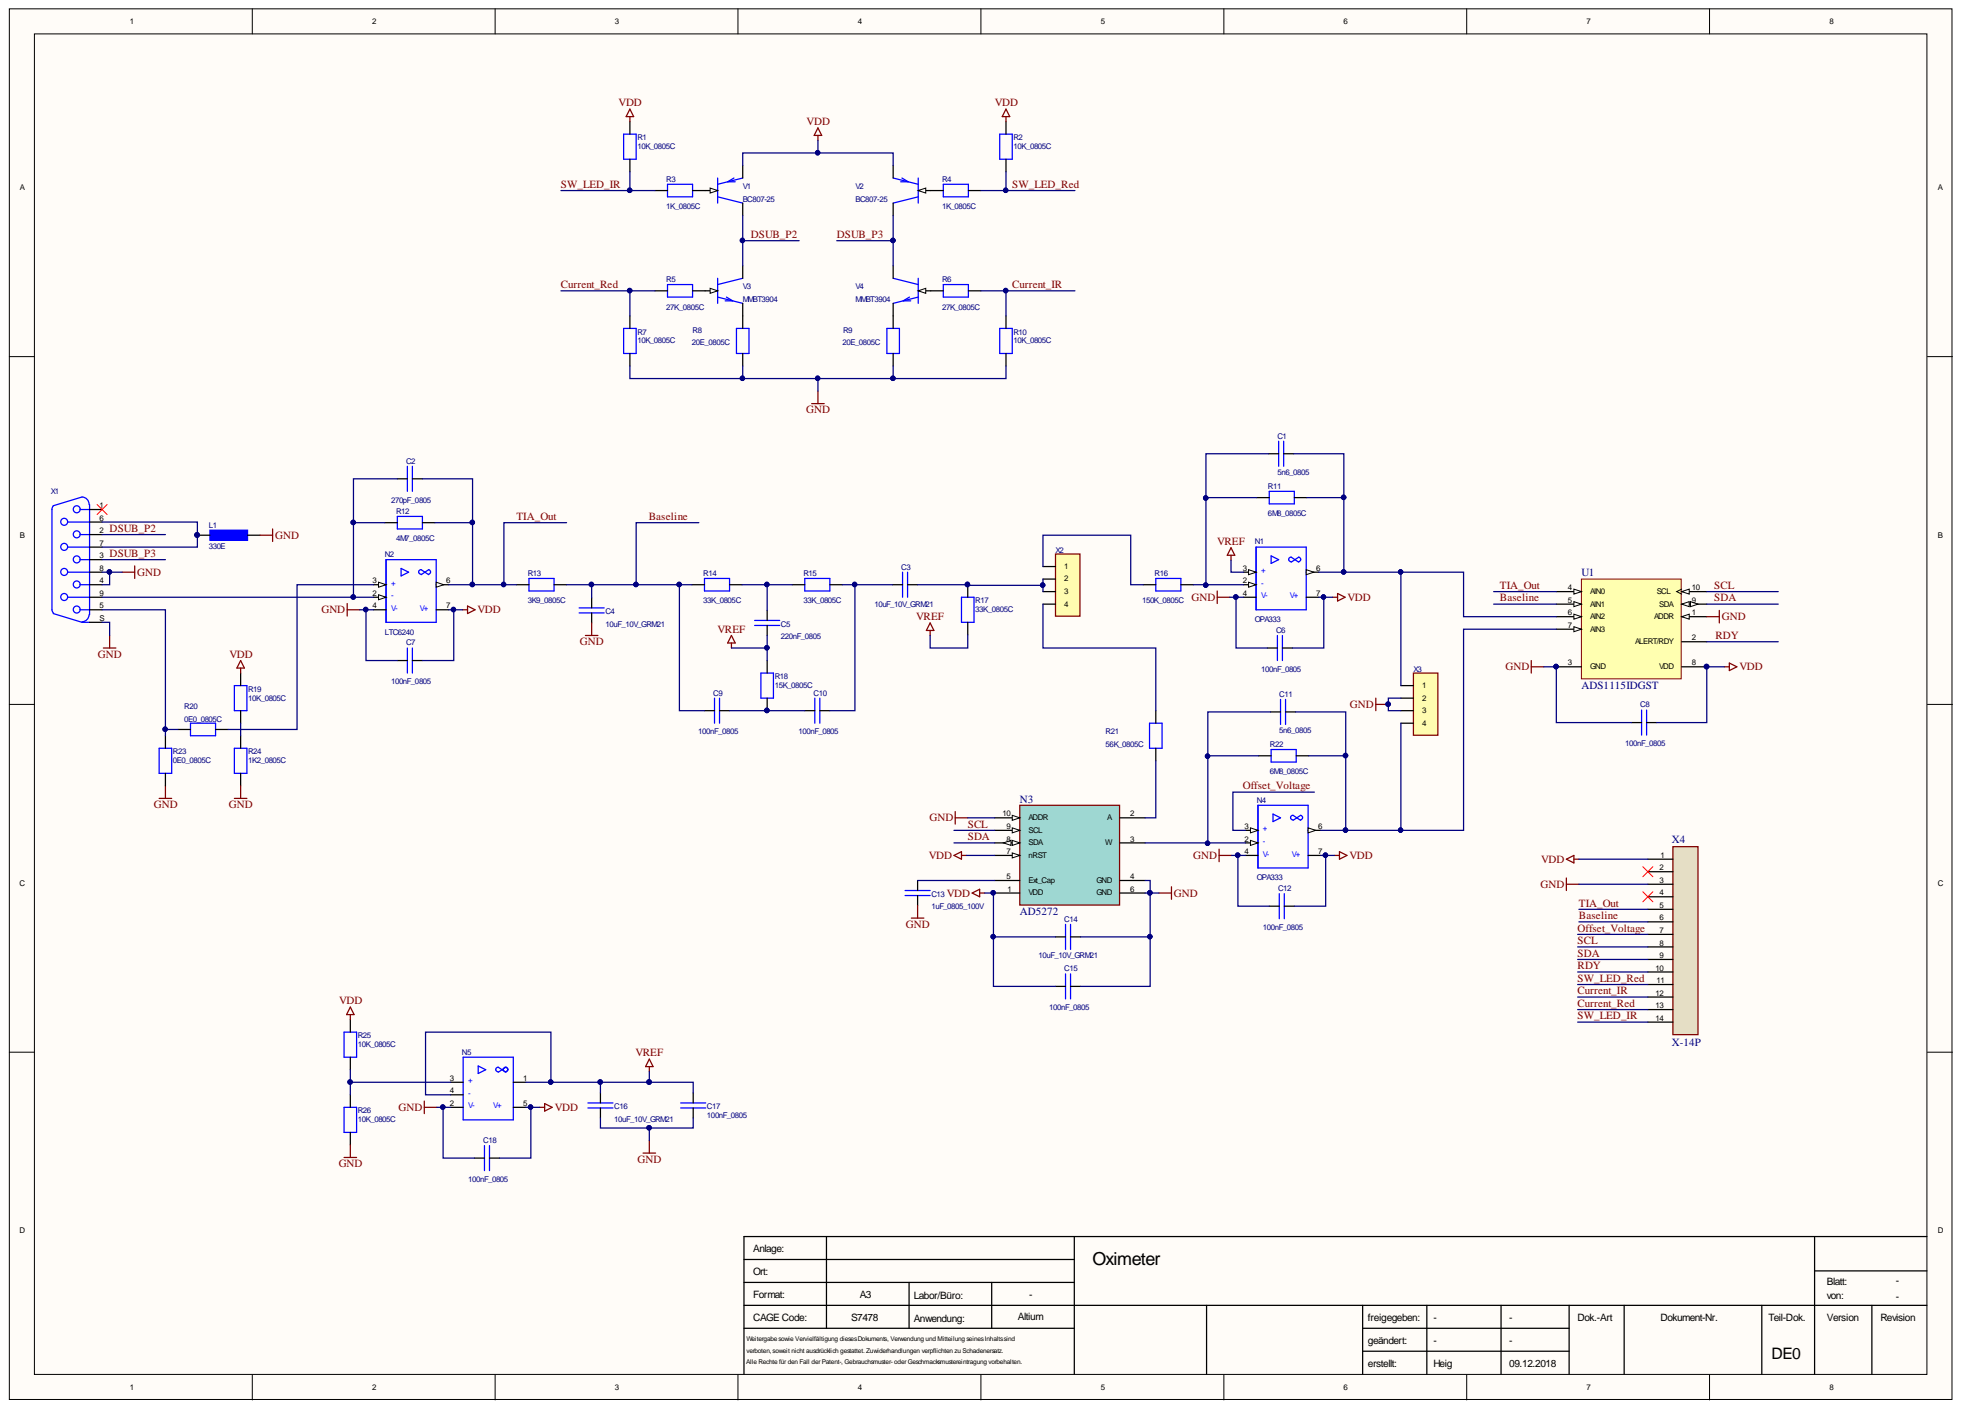
[picture p64: page 1]

Ort:

Format: CAGE Code: | A3 S7478 | Labor/Büro: Anwendung: | -Altium

Weitergabe sowie Vervielfältigung diesesDokuments, Verwendung und Mitteilung seines Inhalts sind

geändert: | - | -

verboten, soweit nicht ausdrücklich gestattet. Zuwiderhandlungen verpflichten zu Schadenersatz.
