gheimsch/Pulse_oximetry/(list of files, drawings)

Other design files:
PCB/Oximeter.PcbDoc
PCB/Oximeter.PrjPcb
PCB/Oximeter.SchDoc
