gheimsch/Pulse_oximetry/(commit log)

2018-12-08 Messdaten hinzugefügt
    [20181207_transImpOut_firstTry.CSV, 20181208_lp_notchOut_long.CSV, 20181208_lp_notch_ampl.CSV, 20181208_lp_notch_ampl46_hp_lp.CSV, 20181208_lp_notch_ampl46_hp_lp_2.CSV, 20181208_lp_notch_ampl_Gunnar.CSV, 20181208_lp_notch_ampl_hp.CSV, 20181208_lp_notch_ampl_hp_lp4Hz.CSV]
2018-12-27 lab work 14./15. dec
    [20181207_transImpOut_firstTry.CSV, 20181208_lp_notchOut_long.CSV, 20181208_lp_notch_ampl.CSV, 20181208_lp_notch_ampl46_hp_lp.CSV, 20181208_lp_notch_ampl46_hp_lp_2.CSV, 20181208_lp_notch_ampl_Gunnar.CSV, 20181208_lp_notch_ampl_hp.CSV, 20181208_lp_notch_ampl_hp_lp4Hz.CSV]
2018-12-27 Added PCB, simulation and pictures
    [Oximeter.PcbDoc, Oximeter.PrjPcb, Oximeter.SchDoc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]
2019-01-04 Added firmware for stm32f4-discovery and updated pcb project
    [Oximeter.PrjPcb, Oximeter.SchDoc, Oximeter.xlsx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]
2019-01-18 generated notch filter images and other images
2019-01-22 Update PowerPoint
